plmwd/HKN-SAE-Project/README.md

# HKN-SAE-Project
A collaboration between UCF's HKN Zeta Chi and SAE club to expand SAE's measurement network for their formula racecar.
