plmwd/HKN-SAE-Project/Board/PowerSenseModule/bom/PowerSenseModule.xlsx

Sheet: BOM
Ref/Product | Qty | In Inventory | Unit Qty | To Order | Value | Footprint/Description | Manufacturer | Manufacturer PN
C4 C19 C21 C20 C22 C14 C11 C26 | 8 | Not in Inventory | 24 | 24 | 0.1uF | Capacitor_SMD:C_0603_1608Metric_Pad1.05x0.95mm_HandSolder | TDK | CGA3E2X7R1H104K080AA | Number of units to buy | 3
M3 Screws | 8 | 0 | 24 | 24 |  |  |  |  | Total number of parts TO BUY | 136
DT06-6S Pin | 6 | Not in Inventory | 18 | 18 | 1062-16-0122 | SOC, SF, SIZE 16, 14-18AWG, NI | TE Connectivity / DEUTSCH | 1062-16-0122 | Total number of parts | 255
C8 C12 C27 | 3 | 0 | 9 | 9 | 22uF | Capacitor_SMD:C_1210_3225Metric_Pad1.42x2.65mm_HandSolder | Samsung | CL32B226MOJNNNE
D1 D8 D9 | 3 | 0 | 9 | 9 | SMBJ9.0CA-13-F | Diode_SMD:D_SMB_Handsoldering | Diodes Incorporated | SMBJ9.0CA-13-F
C3 C13 C10 C24 | 4 | 4 | 12 | 8 | 0.01uF | Capacitor_SMD:C_0603_1608Metric_Pad1.05x0.95mm_HandSolder | KEMET | C0603C103J5RACTU
D2 D5 D6 D7 | 4 | 6 | 12 | 6 | DPUMP | Diode_SMD:D_SOD-323_HandSoldering | Toshiba | CUS10S30,H3F
R9 R6 | 2 | 0 | 6 | 6 | 0 | Resistor_SMD:R_2816_7142Metric_Pad3.20x4.45mm_HandSolder | Keystone Electronics | 5102
C15 | 1 | 0 | 3 | 3 | 10uF | Capacitor_Tantalum_SMD:CP_EIA-3528-12_Kemet-T_Pad1.50x2.35mm_HandSolder | KEMET | T491B106K016ATAUTO
J3 | 1 | 0 | 3 | 3 | Programming Header | Connector_PinHeader_2.54mm:PinHeader_1x06_P2.54mm_Vertical
J4 | 1 | 0 | 3 | 3 | Board Interconnect | Connector_PinHeader_2.54mm:PinHeader_1x02_P2.54mm_Vertical
U2 | 1 | 0 | 3 | 3 | NCV2007x | Package_SO:SOIC-14_3.9x8.7mm_P1.27mm | ON Semiconductor | NCV20074DTBR2G
DT13-6P Female Connector | 1 | Not in Inventory | 3 | 3 | DT06-6S | PLG, 6P, GRY, N | TE Connectivity / DEUTSCH | DT06-6S
DT06-6S Pin Wedge | 1 | Not in Inventory | 3 | 3 | W6S | WEDGE LOCK, 6P, PLG, ORG, STD, DT | TE Connectivity / DEUTSCH | W6S
Enclosure | 1 | Not in Inventory | 3 | 3 | HKN0000ENC01 | Power Sense Module enclosure | HKN | HKN000000ENC00
Enclosure O-Ring | 1 | 0 | 3 | 3
PCB | 1 | 0 | 3 | 3 |  |  | HKN | HKN000001PCB01
J1 | 1 | 1 | 3 | 2 | DT13-6P | Connector_TE:DT13-6P | TE Connectivity / DEUTSCH | DT13-6P | HKN part numbering
D3 | 1 | 2 | 3 | 1 | GREEN_LED | Resistor_SMD:R_0603_1608Metric_Pad1.05x0.95mm_HandSolder | Würth Elektronik | 150060VS75000 | suffix | hex num | type | type number 2 digit
D4 | 1 | 2 | 3 | 1 | RED_LED | Resistor_SMD:R_0603_1608Metric_Pad1.05x0.95mm_HandSolder | Würth Elektronik | 150060RS75000 | HKN | FFFFFF | ENC | FF
U3 | 1 | 2 | 3 | 1 | dsPIC33EV32GM102 | Package_SO:SSOP-28_5.3x10.2mm_P0.65mm | Microchip | dsPIC33EV32GM102-E/SS |  |  | SEN
C17 C18 | 2 | 8 | 6 | 0 | 10pF | Capacitor_SMD:C_0603_1608Metric_Pad1.05x0.95mm_HandSolder | Würth Elektronik | 885012206081 |  |  | PCB
C1 | 1 | 14 | 3 | 0 | 4.7pF | Capacitor_SMD:C_0603_1608Metric_Pad1.05x0.95mm_HandSolder | KEMET | C0603X479C1HACTU
C5 C23 C6 C25 | 4 | 13 | 12 | 0 | 4.7uF | Capacitor_SMD:C_0805_2012Metric_Pad1.15x1.40mm_HandSolder | Murata Electronics | GRM21BC81H475KE11L
C7 C2 | 2 | 8 | 6 | 0 | 470pF | Capacitor_SMD:C_0603_1608Metric_Pad1.05x0.95mm_HandSolder | KEMET | C0603C471J5GAC7411
C9 C16 | 2 | 8 | 6 | 0 | 33nF | Capacitor_SMD:C_0603_1608Metric_Pad1.05x0.95mm_HandSolder | TDK | CGA3E2X7R1H333M080AA
R11 R10 | 2 | 13 | 6 | 0 | 1.2k | Resistor_SMD:R_0603_1608Metric_Pad1.05x0.95mm_HandSolder | Panasonic | ERJ-PA3J122V
R13 R12 | 2 | 13 | 6 | 0 | 75k | Resistor_SMD:R_0603_1608Metric_Pad1.05x0.95mm_HandSolder | Panasonic | ERJ-PA3J753V
R14 R22 | 2 | 13 | 6 | 0 | 1k | Resistor_SMD:R_0603_1608Metric_Pad1.05x0.95mm_HandSolder | Panasonic | ERJ-PA3J102V
R17 R19 | 2 | 13 | 6 | 0 | 4.99k | Resistor_SMD:R_0603_1608Metric_Pad1.05x0.95mm_HandSolder | Vishay / Dale | RCS06034K99FKEA
R18 R4 R16 R15 | 4 | 16 | 12 | 0 | 10k | Resistor_SMD:R_0603_1608Metric_Pad1.05x0.95mm_HandSolder | Panasonic | ERJ-PA3J103V
R2 | 1 | 9 | 3 | 0 | 523k | Resistor_SMD:R_0603_1608Metric_Pad1.05x0.95mm_HandSolder | Bourns | CR0603-FX-5233ELF
R20 R21 | 2 | 13 | 6 | 0 | 300 | Resistor_SMD:R_0603_1608Metric_Pad1.05x0.95mm_HandSolder | Panasonic | ERJ-PA3J301V
R3 R1 | 2 | 8 | 6 | 0 | 100k | Resistor_SMD:R_0603_1608Metric_Pad1.05x0.95mm_HandSolder | Vishay / Dale | CRCW0603100KFKEA
R5 | 1 | 14 | 3 | 0 | 470 | Resistor_SMD:R_0603_1608Metric_Pad1.05x0.95mm_HandSolder | Panasonic | ERJ-PA3J471V
R7 | 1 | 14 | 3 | 0 | 120 | Resistor_SMD:R_0603_1608Metric_Pad1.05x0.95mm_HandSolder | Panasonic | ERJ-PA3J121V
R8 | 1 | 4 | 3 | 0 | 4m | Resistor_SMD:R_4020_10251Metric_Pad1.65x5.30mm_HandSolder | Vishay | WSLP39214L000FEB
U1 | 1 | 4 | 3 | 0 | TPS82150 | Package_LGA:Texas_SIL0008D_MicroSiP-8-1EP_2.8x3mm_P0.65mm_EP1.1x1.9mm | TI | TPS82150SILR
U4 | 1 | 5 | 3 | 0 | MCP2542FDxMF | Package_SO:SOIC-8_3.9x4.9mm_P1.27mm | Microchip | MCP2542FD-H/SN
Y1 | 1 | 3 | 3 | 0 | 25 MHz | ABRACON_4PIN:Crystal_SMD_S2.05mm_L2.55 | Abracon | ABM10AIG-25.000MHZ-4Z-T3

Sheet: Inventory
Qty | Value | In Design? | Footprint | Manufacturer | Manufacturer PN
3 | 0 | No | Resistor_SMD:R_0603_1608Metric_Pad1.05x0.95mm_HandSolder | Keystone | 5110
0 | 0 | Yes | Resistor_SMD:R_2816_7142Metric_Pad3.20x4.45mm_HandSolder | Keystone | 5102
4 | 0.01uF | Yes | Capacitor_SMD:C_0603_1608Metric_Pad1.05x0.95mm_HandSolder | KEMET | C0603C103J5RACTU
92 | 0.1uF | Yes | Capacitor_SMD:C_0603_1608Metric_Pad1.05x0.95mm_HandSolder | Murata Electronics | GRM21BR71C475KE51L
13 | 1.2k | Yes | Resistor_SMD:R_0603_1608Metric_Pad1.05x0.95mm_HandSolder | Panasonic | ERJ-PA3J122V
8 | 100k | Yes | Resistor_SMD:R_0603_1608Metric_Pad1.05x0.95mm_HandSolder | Vishay / Dale | CRCW0603100KFKEA
16 | 10k | Yes | Resistor_SMD:R_0603_1608Metric_Pad1.05x0.95mm_HandSolder | Panasonic | ERJ-PA3J103V
0 | 10pF | No | Capacitor_SMD:C_0603_1608Metric_Pad1.05x0.95mm_HandSolder | KEMET | C0603C100J5GAC3190
8 | 10pF | Yes | Capacitor_SMD:C_0603_1608Metric_Pad1.05x0.95mm_HandSolder | Würth Elektronik | 885012206081
0 | 10uF | No | Capacitor_Tantalum_SMD:CP_EIA-3528-12_Kemet-T_Pad1.50x2.35mm_HandSolder | KEMET | T491B106K016ATAUTO
0 | 10uF | No | Capacitor_Tantalum_SMD:CP_EIA-3528-12_Kemet-T_Pad1.50x2.35mm_HandSolder | Würth Elektronik | 885012206092
2 | 10uF | Yes | Capacitor_Tantalum_SMD:CP_EIA-3528-12_Kemet-T_Pad1.50x2.35mm_HandSolder | AVX | TPSB106K020R0500
14 | 120 | Yes | Resistor_SMD:R_0603_1608Metric_Pad1.05x0.95mm_HandSolder | Panasonic | ERJ-PA3J121V
13 | 1k | Yes | Resistor_SMD:R_0603_1608Metric_Pad1.05x0.95mm_HandSolder | Panasonic | ERJ-PA3J102V
0 | 22uF | Yes | Capacitor_SMD:C_1210_3225Metric_Pad1.42x2.65mm_HandSolder | Samsung | CL32B226MOJNNNE
3 | 25 MHz | Yes | ABRACON_4PIN:Crystal_SMD_S2.05mm_L2.55 | Abracon | ABM10AIG-25.000MHZ-4Z-T3
13 | 300 | Yes | Resistor_SMD:R_0603_1608Metric_Pad1.05x0.95mm_HandSolder | Panasonic | ERJ-PA3J301V
8 | 33nF | Yes | Capacitor_SMD:C_0603_1608Metric_Pad1.05x0.95mm_HandSolder | TDK | CGA3E2X7R1H333M080AA
14 | 4.7pF | Yes | Capacitor_SMD:C_0603_1608Metric_Pad1.05x0.95mm_HandSolder | KEMET | C0603X479C1HACTU
13 | 4.7uF | Yes | Capacitor_SMD:C_0805_2012Metric_Pad1.15x1.40mm_HandSolder | Murata Electronics | GRM21BC81H475KE11L
13 | 4.99k | Yes | Resistor_SMD:R_0603_1608Metric_Pad1.05x0.95mm_HandSolder | Vishay / Dale | RCS06034K99FKEA
14 | 470 | Yes | Resistor_SMD:R_0603_1608Metric_Pad1.05x0.95mm_HandSolder | Panasonic | ERJ-PA3J471V
8 | 470pF | Yes | Capacitor_SMD:C_0603_1608Metric_Pad1.05x0.95mm_HandSolder | KEMET | C0603C471J5GAC7411
2 | 47uF | No | Capacitor_SMD:C_1210_3225Metric_Pad1.42x2.65mm_HandSolder | Taiyo Yuden | EMK325ABJ476MMHP
3 | 4m | Yes | Resistor_SMD:R_4020_10251Metric_Pad1.65x5.30mm_HandSolder | Vishay | WSLP39214L000FEA
4 | 4m | Yes | Resistor_SMD:R_4020_10251Metric_Pad1.65x5.30mm_HandSolder | Vishay | WSLP39214L000FEB
9 | 523k | Yes | Resistor_SMD:R_0603_1608Metric_Pad1.05x0.95mm_HandSolder | Bourns | CR0603-FX-5233ELF
2 | 6.8uF | No | Capacitor_SMD:C_1210_3225Metric_Pad1.42x2.65mm_HandSolder | TDK | CGA6P3X7S1H685K250AB
13 | 75k | Yes | Resistor_SMD:R_0603_1608Metric_Pad1.05x0.95mm_HandSolder | Panasonic | ERJ-PA3J753V
6 | DPUMP | Yes | Diode_SMD:D_SOD-323_HandSoldering | Toshiba | CUS10S30,H3F
2 | dsPIC33EV32GM102 | Yes | Package_SO:SSOP-28_5.3x10.2mm_P0.65mm | Microchip | dsPIC33EV32GM102-E/SS
1 | DT13-6P | Yes | Connector_TE:DT13-6P | TE Connectivity / DEUTSCH | DT13-6P
2 | GREEN_LED | Yes | Resistor_SMD:R_0603_1608Metric_Pad1.05x0.95mm_HandSolder | Wurth Elektronik | 150060VS75000
 | Male Headers | Yes | Connector_PinHeader_2.54mm:PinHeader_1x01_P2.54mm_Vertical
5 | MCP2542FDxMF | Yes | Package_SO:SOIC-8_3.9x4.9mm_P1.27mm | Microchip | MCP2542FD-H/SN
0 | NCV2007x | Yes | Package_SO:TSSOP-14_4.4x5mm_P0.65mm | ON Semiconductor | NCV20074DTBR2G
6 | NCV2007x | No | Package_SO:SOIC-14_3.9x8.7mm_P1.27mm | ON Semiconductor | NCV20074DR2G
2 | RED_LED | Yes | Resistor_SMD:R_0603_1608Metric_Pad1.05x0.95mm_HandSolder | Wurth Elektronik | 150060RS75000
0 | SMBJ9.0CA-13-F | Yes | Diode_SMD:D_SMB_Handsoldering | Diodes Incorporated | SMBJ9.0CA-13-F
4 | TPS82150 | Yes | Package_LGA:Texas_SIL0008D_MicroSiP-8-1EP_2.8x3mm_P0.65mm_EP1.1x1.9mm | TI | TPS82150SILR
9 | PCB Rev 1 | No |  | HKN | HKN000001PCB00
0 | PCB Rev 1.1 | Yes |  | HKN | HKN000001PCB01
