plmwd/HKN-SAE-Project/Board/PowerSenseModule/bom/PowerSenseModule.csv

Ref | Qty | Value | Footprint | Manufacturer | Manufacturer PN | Price 1 QTY | Supplier | Supplier Link | Supplier PN
C7 C2 | 2 | 470pF | Capacitor_SMD:C_0603_1608Metric_Pad1.05x0.95mm_HandSolder | KEMET | C0603C471J5GAC7411 | 0.21 | Mouser | https://www.mouser.com/ProductDetail/KEMET/C0603C471J5GAC7411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 | 80-C0603C471J5G7411
C5 C23 C6 C25 | 4 | 4.7uF | Capacitor_SMD:C_0805_2012Metric_Pad1.15x1.40mm_HandSolder | Murata Electronics | GRM21BC81H475KE11L | 0.49 | Digikey | https://www.digikey.com/product-detail/en/murata-electronics/GRM21BC81H475KE11L/490-14658-1-ND/6606264 | 490-14658-1-ND
C4 C19 C21 C20 C22 C14 C11 C26 | 8 | 0.1uF | Capacitor_SMD:C_0603_1608Metric_Pad1.05x0.95mm_HandSolder | TDK | CGA3E2X7R1H104K080AA | 0.1 | Mouser | https://www.mouser.com/ProductDetail/TDK/CGA3E2X7R1H104K080AA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 | 810-CGA3E2X7R1H104K
C3 C13 C10 C24 | 4 | 0.01uF | Capacitor_SMD:C_0603_1608Metric_Pad1.05x0.95mm_HandSolder | KEMET | C0603C103J5RACTU | 0.10 | Mouser | https://www.mouser.com/ProductDetail/KEMET/C0603C103J5RACTU?qs=sGAEpiMZZMs0AnBnWHyRQJxdEn2F2BG1SUc13Z4vudE%3D | 80-C0603C103J5R
C1 | 1 | 4.7pF | Capacitor_SMD:C_0603_1608Metric_Pad1.05x0.95mm_HandSolder | KEMET | C0603X479C1HACTU | 0.12 | Mouser | https://www.mouser.com/ProductDetail/KEMET/C0603X479C1HACTU | 80-C0603X479C1HACTU
C8 C12 C27 | 3 | 22uF | Capacitor_SMD:C_1210_3225Metric_Pad1.42x2.65mm_HandSolder | Samsung | CL32B226MOJNNNE | 0.61 | Digikey | https://www.digikey.com/product-detail/en/samsung-electro-mechanics/CL32B226MOJNNNE/1276-3395-1-ND/3891481 | 1276-3395-1-ND
C17 C18 | 2 | 10pF | Capacitor_SMD:C_0603_1608Metric_Pad1.05x0.95mm_HandSolder | KEMET | C0603C100J5GAC3190 | 0.1 | Mouser | https://www.mouser.com/ProductDetail/KEMET/C0603C100J5GAC3190 | 80-C0603C100J5G3190
C9 C16 | 2 | 33nF | Capacitor_SMD:C_0603_1608Metric_Pad1.05x0.95mm_HandSolder | TDK | CGA3E2X7R1H333M080AA | 0.1 | Mouser | https://www.mouser.com/ProductDetail/TDK/CGA3E2X7R1H333M080AA | 810-CGA3E2X7R1H333MA
C15 | 1 | 10uF | Capacitor_Tantalum_SMD:CP_EIA-3528-12_Kemet-T_Pad1.50x2.35mm_HandSolder | KEMET | T491B106K016ATAUTO | 0.57 | Mouser | https://www.mouser.com/ProductDetail/KEMET/T491B106K016ATAUTO | 80-T491B106K016AUTO
D2 D5 D6 D7 | 4 | DPUMP | Diode_SMD:D_SOD-323_HandSoldering | Toshiba | CUS10S30 H3F | 0.42 | Mouser | https://www.mouser.com/ProductDetail/Toshiba/CUS10S30H3F | 757-CUS10S30H3F
D1 D8 D9 | 3 | SMBJ9.0CA-13-F | Diode_SMD:D_SMB_Handsoldering | Diodes Incorporated | SMBJ9.0CA-13-F | 0.36 | Digikey | https://www.digikey.com/product-detail/en/diodes-incorporated/SMBJ9.0CA-13-F/SMBJ9.0CA-FDICT-ND/775877 | SMBJ9.0CA-FDICT-ND
D4 | 1 | RED_LED | Resistor_SMD:R_0603_1608Metric_Pad1.05x0.95mm_HandSolder | Würth Elektronik | 150060RS75000 | 0.14 | Digikey | https://www.digikey.com/product-detail/en/w-rth-elektronik/150060RS75000/732-4978-1-ND/4489899 | 732-4978-1-ND
D3 | 1 | GREEN_LED | Resistor_SMD:R_0603_1608Metric_Pad1.05x0.95mm_HandSolder | Würth Elektronik | 150060VS75000 | 0.14 | Digikey | https://www.digikey.com/product-detail/en/w-rth-elektronik/150060VS75000/732-4980-1-ND/4489904 | 732-4980-1-ND
G1 | 1 | LOGO | Logo:HKNZetaChi
H1 H2 | 2 |  | MountingHole:MountingHole_2.7mm_M2.5_Pad
J1 | 1 | DT13-6P | Connector_TE:DT13-6P | TE Connectivity / DEUTSCH | DT13-6P | 9.15 | Mouser | https://www.mouser.com/ProductDetail/TE-Connectivity-DEUTSCH/DT13-6P | 571-DT13-6P
J3 | 1 | Programming Header | Connector_PinHeader_2.54mm:PinHeader_1x06_P2.54mm_Vertical |  |  |  |  | https://www.amazon.com/gp/product/B07VNXL5BD/ref=ppx_yo_dt_b_asin_title_o04_s00?ie=UTF8&psc=1
J4 | 1 | Board Interconnect | Connector_PinHeader_2.54mm:PinHeader_1x02_P2.54mm_Vertical |  |  |  |  | https://www.amazon.com/gp/product/B07VNXL5BD/ref=ppx_yo_dt_b_asin_title_o04_s00?ie=UTF8&psc=1
NT1 | 1 | Net-Tie_2 | NetTie:NetTie-2_SMD_Pad2.0mm
R3 R1 | 2 | 100k | Resistor_SMD:R_0603_1608Metric_Pad1.05x0.95mm_HandSolder | Vishay / Dale | CRCW0603100KFKEA | 0.1 | Mouser | https://www.mouser.com/ProductDetail/Vishay-Dale/CRCW0603100KFKEA | 71-CRCW0603-100K-E3
R2 | 1 | 523k | Resistor_SMD:R_0603_1608Metric_Pad1.05x0.95mm_HandSolder | Bourns | CR0603-FX-5233ELF | 0.1 | Mouser | https://www.mouser.com/ProductDetail/Bourns/CR0603-FX-5233ELF | 652-CR0603FX-5233ELF
R7 | 1 | 120 | Resistor_SMD:R_0603_1608Metric_Pad1.05x0.95mm_HandSolder | Panasonic | ERJ-PA3J121V | 0.1 | Digikey | https://www.digikey.com/product-detail/en/panasonic-electronic-components/ERJ-PA3J121V/P120BZCT-ND/5036246 | P120BZCT-ND
R20 R21 | 2 | 300 | Resistor_SMD:R_0603_1608Metric_Pad1.05x0.95mm_HandSolder | Panasonic | ERJ-PA3J301V | 0.1 | Digikey | https://www.digikey.com/product-detail/en/panasonic-electronic-components/ERJ-PA3J301V/P300BZCT-ND/5036302 | P300BZCT-ND
R9 R6 | 2 | 0 | Resistor_SMD:R_2816_7142Metric_Pad3.20x4.45mm_HandSolder | Keystone | 5102 | 0.22 | Digikey | https://www.digikey.com/product-detail/en/keystone-electronics/5102/36-5102-ND/4780768 | 36-5102-ND
R14 R22 | 2 | 1k | Resistor_SMD:R_0603_1608Metric_Pad1.05x0.95mm_HandSolder | Panasonic | ERJ-PA3J102V | 0.1 | Digikey | https://www.digikey.com/product-detail/en/panasonic-electronic-components/ERJ-PA3J102V/P1KBZCT-ND/5036236 | P1KBZCT-ND
R13 R12 | 2 | 75k | Resistor_SMD:R_0603_1608Metric_Pad1.05x0.95mm_HandSolder | Panasonic | ERJ-PA3J753V | 0.1 | Digikey | https://www.digikey.com/product-detail/en/panasonic-electronic-components/ERJ-PA3J753V/P75KBZCT-ND/5036364 | P75KBZCT-ND
R8 | 1 | 4m | Resistor_SMD:R_4020_10251Metric_Pad1.65x5.30mm_HandSolder | Vishay | WSLP39214L000FEB | 2.18 | Mouser | https://www.mouser.com/ProductDetail/Vishay-Dale/WSLP39214L000FEB | 71- 71-WSLP39214L000FEB
R17 R19 | 2 | 4.99k | Resistor_SMD:R_0603_1608Metric_Pad1.05x0.95mm_HandSolder | Vishay / Dale | RCS06034K99FKEA | 0.14 | Digikey | https://www.digikey.com/product-detail/en/vishay-dale/RCS06034K99FKEA/541-2794-1-ND/5867087 | 541-2794-1-ND
R18 R4 R16 R15 | 4 | 10k | Resistor_SMD:R_0603_1608Metric_Pad1.05x0.95mm_HandSolder | Panasonic | ERJ-PA3J103V | 0.1 | Digikey | https://www.digikey.com/product-detail/en/panasonic-electronic-components/ERJ-PA3J103V/P10KBZCT-ND/5036237 | P10KBZCT-ND
R5 | 1 | 470 | Resistor_SMD:R_0603_1608Metric_Pad1.05x0.95mm_HandSolder | Panasonic | ERJ-PA3J471V | 0.1 | Digikey | https://www.digikey.com/product-detail/en/panasonic-electronic-components/ERJ-PA3J471V/P470BZCT-ND/5036331 | P470BZCT-ND
R11 R10 | 2 | 1.2k | Resistor_SMD:R_0603_1608Metric_Pad1.05x0.95mm_HandSolder | Panasonic | ERJ-PA3J122V | 0.1 | Digikey | https://www.digikey.com/product-detail/en/panasonic-electronic-components/ERJ-PA3J122V/P1.2KBZCT-ND/5036247 | P1.2KBZCT-ND
U1 | 1 | TPS82150 | Package_LGA:Texas_SIL0008D_MicroSiP-8-1EP_2.8x3mm_P0.65mm_EP1.1x1.9mm | TI | TPS82150SILR | 3.03 | Mouser | https://www.mouser.com/ProductDetail/?qs=gt1LBUVyoHksxpRVOmIIkg%3D%3D | 595-TPS82150SILR
U4 | 1 | MCP2542FDxMF | Package_SO:SOIC-8_3.9x4.9mm_P1.27mm | Microchip | MCP2542FD-H/SN | 0.79 | Mouser | https://www.mouser.com/ProductDetail/Microchip-Technology/MCP2542FD-H-SN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 | 579-MCP2542FD-H/SN
U2 | 1 | NCV2007x | Package_SO:SOIC-14_3.9x8.7mm_P1.27mm | ON Semiconductor | NCV20074DTBR2G | 1.01 | Digikey | https://www.digikey.com/product-detail/en/on-semiconductor/NCV20074DTBR2G/NCV20074DTBR2GOSCT-ND/9087194 | NCV20074DTBR2GOSCT-ND
U3 | 1 | dsPIC33EV32GM102 | Package_SO:SSOP-28_5.3x10.2mm_P0.65mm | Microchip | dsPIC33EV32GM102-E/SS | 3.04 | Mouser | https://www.mouser.com/ProductDetail/Microchip-Technology/dsPIC33EV32GM102-E-SS | 579-33EV32GM102ESS
Y1 | 1 | 25 MHz | ABRACON_4PIN:Crystal_SMD_S2.05mm_L2.55 | Abracon | ABM10AIG-25.000MHZ-4Z-T3 | 1.30 | Mouser | https://www.mouser.com/ProductDetail/ABRACON/ABM10AIG-25000MHZ-4Z-T3 | 815-M10AIG-25-4ZT3
