plmwd/HKN-SAE-Project/Design Files/PowerSenseModule.xlsx

Ref | Qnty | Value | Supplier | Supplier Part Number | Manufacture Part Number | Unit Price | Price Break | Qnty Price | Extended Price | Extended Order Price | Link | Footprint | Description
C1, | 1 | 4.7pF | Digikey | 1276-1282-1-ND | CL10C4R7CB8NNNC | 0.0257 | 100 | 0.0257 | 2.57 | 2.57 | https://www.digikey.com/product-detail/en/samsung-electro-mechanics/CL10C4R7CB8NNNC/1276-1282-1-ND/3889368 | Capacitor_SMD:C_0603_1608Metric_Pad1.05x0.95mm_HandSolder | Unpolarized capacitor
C2, C7 | 2 | 470pF | Digikey | 1276-6635-1-ND | CL10B471KB8WPNC | 0.0186 | 100 | 0.0372 | 1.86 | 1.86 | https://www.digikey.com/product-detail/en/samsung-electro-mechanics/CL10B471KB8WPNC/1276-6635-1-ND/5961494 | Capacitor_SMD:C_0603_1608Metric_Pad1.05x0.95mm_HandSolder | Unpolarized capacitor
C3, C10, C13, C21, | 4 | 0.01uF | Digikey | 1276-6841-1-ND | CL10B103KB8WPNC | 0.0282 | 100 | 0.1128 | 2.82 | 2.82 | https://www.digikey.com/product-detail/en/samsung-electro-mechanics/CL10B103KB8WPNC/1276-6841-1-ND/5961700 | Capacitor_SMD:C_0603_1608Metric_Pad1.05x0.95mm_HandSolder | Unpolarized capacitor
C4, C12, C11, C14, C24, C20, C23, | 7 | 0.1uF | Digikey | 1276-6994-1-ND | CL10B104KB85PNL | 0.0437 | 100 | 0.3059 | 4.37 | 4.37 | https://www.digikey.com/product-detail/en/samsung-electro-mechanics/CL10B104KB85PNL/1276-6994-1-ND/7320636 | Capacitor_SMD:C_0603_1608Metric_Pad1.05x0.95mm_HandSolder | Unpolarized capacitor
C5, | 1 | 4.7uF | Digikey | 1276-2969-1-ND | CL21B475KAFNNNE | 0.305 | 10 | 0.305 | 3.05 | 3.05 | https://www.digikey.com/product-detail/en/samsung-electro-mechanics/CL21B475KAFNNNE/1276-2969-1-ND/3891055 | Capacitor_SMD:C_0805_2012Metric_Pad1.15x1.40mm_HandSolder | Unpolarized capacitor
C6, | 1 | 10uF | Digikey | PCE4549CT-ND | EEE-FPV100UAR | 0.29 | 10 | 0.29 | 2.9 | 2.9 | https://www.digikey.com/product-detail/en/panasonic-electronic-components/EEE-FPV100UAR/PCE4549CT-ND/1701048 | elec 4x5.8 | Unpolarized capacitor
C8, | 1 | 47uF | Digikey | PCE4552CT-ND | EEE-FP1V470AP | 0.36 | 10 | 0.36 | 3.6 | 3.6 | https://www.digikey.com/product-detail/en/panasonic-electronic-components/EEE-FP1V470AP/PCE4552CT-ND/1701051 | elec 6.3x5.8 | Unpolarized capacitor
C9, | 1 | 150uF | Digikey | PCE5016CT-ND | EEE-FT1V101AP | 0.417 | 10 | 0.417 | 4.17 | 4.17 | https://www.digikey.com/product-detail/en/panasonic-electronic-components/EEE-FT1V101AP/PCE5016CT-ND/2652071 | elec 6.3x5.9 | Polarized capacitor
C15, | 1 | 10uF | Digikey | 718-2156-1-ND | T55B106M016C0100 | 1.09 | 1 | 1.09 | 1.09 | 10.9 | https://www.digikey.com/product-detail/en/vishay-sprague/T55B106M016C0100/718-2156-1-ND/6230386 | tantalum 3528 | Polarized capacitor, US symbol
C16, C17, | 2 | 3.3nF | Digikey | 399-17588-1-ND | C0603C302K5JACAUTO | 0.0365 | 100 | 0.073 | 3.65 | 3.65 | https://www.digikey.com/product-detail/en/kemet/C0603C332J5RACAUTO/399-17588-1-ND/8572588 | Capacitor_SMD:C_0603_1608Metric_Pad1.05x0.95mm_HandSolder | Unpolarized capacitor
C18, | 1 | 820pF | Digikey | 399-17600-1-ND | C0603C821K5RACAUTO | 0.0506 | 100 | 0.0506 | 5.06 | 5.06 | https://www.digikey.com/product-detail/en/kemet/C0603C821K5RACAUTO/399-17600-1-ND/8572600 | Capacitor_SMD:C_0603_1608Metric_Pad1.05x0.95mm_HandSolder | Unpolarized capacitor
C19, C22, | 2 | 1uF | Digikey | 1276-6470-1-ND | CL21B105KBFNNNG | 0.0477 | 100 | 0.0954 | 4.77 | 4.77 | https://www.digikey.com/product-detail/en/samsung-electro-mechanics/CL21B105KBFNNNG/1276-6470-1-ND/5958098 | Capacitor_SMD:C_0805_2012Metric_Pad1.15x1.40mm_HandSolder | Unpolarized capacitor
D2, D1, | 2 | TVS1400 | Digikey | 296-50511-1-ND | TVS1400DRVR | 0.545 | 10 | 1.09 | 5.45 | 5.45 | https://www.digikey.com/product-detail/en/texas-instruments/TVS1400DRVR/296-50511-1-ND/9685650 | Package_SON_Custom:WSON-6-2NET-1EP_2x2mm_P0.65mm_EP1x1.6mm | 14-V Flat-Clamp Surge Protection Device
J2, | 1 | Power/CAN Connector | Digikey | 1734-1025-ND | DT13-6P | 9.18 | 1 | 9.18 | 9.18 | 91.8 | https://www.digikey.com/products/en?keywords=dt13-6p | Connector_TE:DT13-6P
J3, | 1 | Programming Header | Digikey |  |  |  |  | 0 | 0 | 0 |  | Connector_PinHeader_2.54mm:PinHeader_1x06_P2.54mm_Vertical
JP1, | 1 | Jumper_NO_Small | Digikey |  |  |  |  | 0 | 0 | 0 |  | Connector_PinHeader_2.54mm:PinHeader_1x02_P2.54mm_Vertical | Jumper, normally open, small symbol
R2, | 1 | 523k | Digikey |  |  |  |  | 0 | 0 | 0 |  | Resistor_SMD:R_0603_1608Metric_Pad1.05x0.95mm_HandSolder | Resistor, US symbol
R3, R1, | 2 | 100k | Digikey |  |  |  |  | 0 | 0 | 0 |  | Resistor_SMD:R_0603_1608Metric_Pad1.05x0.95mm_HandSolder | Resistor, US symbol
R4, R6, R17, R15, | 4 | 10k | Digikey |  |  |  |  | 0 | 0 | 0 |  | Resistor_SMD:R_0603_1608Metric_Pad1.05x0.95mm_HandSolder | Resistor, US symbol
R5, | 1 | 470 | Digikey |  |  |  |  | 0 | 0 | 0 |  | Resistor_SMD:R_0603_1608Metric_Pad1.05x0.95mm_HandSolder | Resistor, US symbol
R7, | 1 | 120 | Digikey |  |  |  |  | 0 | 0 | 0 |  | Resistor_SMD:R_0603_1608Metric_Pad1.05x0.95mm_HandSolder | Resistor, US symbol
R8, | 1 | 2m | Digikey |  |  |  |  | 0 | 0 | 0 |  | Resistor_SMD:R_Shunt_Vishay_WSK2512_6332Metric_T1.19mm | Shunt resistor, US symbol
R9, R12, | 2 | 499k | Digikey |  |  |  |  | 0 | 0 | 0 |  | Resistor_SMD:R_0603_1608Metric_Pad1.05x0.95mm_HandSolder | Resistor, US symbol
R11, R10, R14, | 3 | 1k | Digikey |  |  |  |  | 0 | 0 | 0 |  | Resistor_SMD:R_0603_1608Metric_Pad1.05x0.95mm_HandSolder | Resistor, US symbol
R13, | 1 | 34.8k | Digikey |  |  |  |  | 0 | 0 | 0 |  | Resistor_SMD:R_0603_1608Metric_Pad1.05x0.95mm_HandSolder | Resistor, US symbol
R16, | 1 | 10 | Digikey |  |  |  |  | 0 | 0 | 0 |  | Resistor_SMD:R_0603_1608Metric_Pad1.05x0.95mm_HandSolder | Resistor, US symbol
U1, | 1 | TPS82150 | Digikey | 296-50509-1-ND | TPS82150SILR | 3.12 | 1 | 3.12 | 3.12 | 31.2 | https://www.digikey.com/product-detail/en/texas-instruments/TPS82150SILR/296-50509-1-ND/9685648 | Package_LGA:Texas_SIL0008D_MicroSiP-8-1EP_2.8x3mm_P0.65mm_EP1.1x1.9mm | 17V Input 1A Step-Down Converter MicroSiP Module with Integrated Inductor, Î¼SiL-8
U2, | 1 | ZLDO117 | Digikey | ZLDO1117QG33TADICT-ND | ZLDO1117QG33TA | 0.544 | 10 | 0.544 | 5.44 | 5.44 | https://www.digikey.com/product-detail/en/diodes-incorporated/ZLDO1117QG33TA/ZLDO1117QG33TADICT-ND/8545998 | Package_TO_SOT_SMD:SOT-223 | LDO linear regular - fixed 3V3
U3, | 1 | dsPIC33EP32GP502 | Digikey | DSPIC33EP32GP502-E/MM-ND | DSPIC33EP32GP502-E/MM | 2.55 | 1 | 2.55 | 2.55 | 25.5 | https://www.digikey.com/product-detail/en/microchip-technology/DSPIC33EP32GP502-E-MM/DSPIC33EP32GP502-E-MM-ND/3871860 | Package_DFN_QFN:QFN-28-1EP_6x6mm_P0.65mm_EP4.25x4.25mm_ThermalVias | 16bit MCU
U4, | 1 | MCP2542FDxMF | Digikey | MCP2542FD-E/MF-ND | MCP2542FD-E/MF | 0.83 | 1 | 0.83 | 0.83 | 8.3 | https://www.digikey.com/product-detail/en/microchip-technology/MCP2542FD-E-MF/MCP2542FD-E-MF-ND/9826383 | Package_DFN_QFN:DFN-8-1EP_3x3mm_P0.65mm_EP1.55x2.4mm | CAN-FD Transceiver, Wake-Up on CAN activity, 8Mbps, 5V supply, STBY pin, 3x3 DFN-8
U5, | 1 | MCP9700AT-ETT | Digikey | MCP9700AT-E/TTCT-ND | MCP9700AT-E/TT | 0.32 | 1 | 0.32 | 0.32 | 3.2 | https://www.digikey.com/product-detail/en/microchip-technology/MCP9700AT-E-TT/MCP9700AT-E-TTCT-ND/3622388 | Package_TO_SOT_SMD:SOT-23 | Low power, analog thermistor temperature sensor, Â±2C accuracy, -40C to +125C, in SOT-23-3
U6, | 1 | MCP39F511A | Digikey | MCP39F511AT-E/MQCT-ND | MCP39F511AT-E/MQ | 2.6 | 1 | 2.6 | 2.6 | 26 | https://www.digikey.com/product-detail/en/microchip-technology/MCP39F511AT-E-MQ/MCP39F511AT-E-MQCT-ND/8639369 | Package_DFN_QFN:QFN-28-1EP_5x5mm_P0.5mm_EP3.35x3.35mm | Power sensing module
Total
# of Components per Unit | 52
Unit Price | 23.3966
# Units | 10
Buy Price | 246.61
