plmwd/HKN-SAE-Project/Board/PowerSenseModule/bom/PowerSenseModule-Order-OSHPark.png

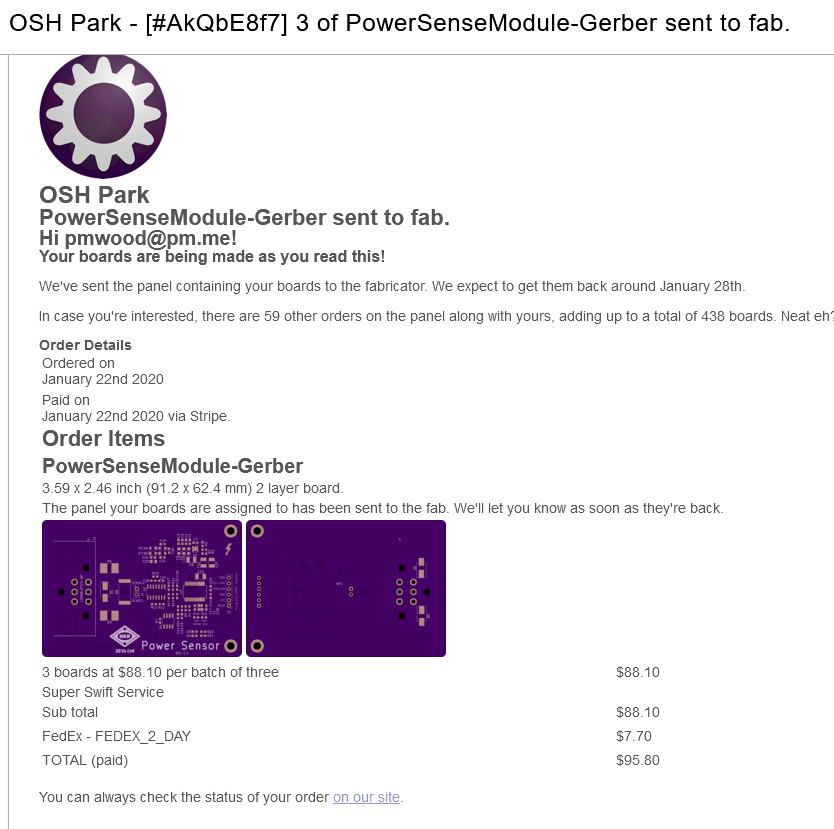
Board/PowerSenseModule/bom/PowerSenseModule-Order-OSHPark.png
