plmwd/HKN-SAE-Project/Board/WBDesign_BuckConverter.pdf

## WEBENCH ® Design Report

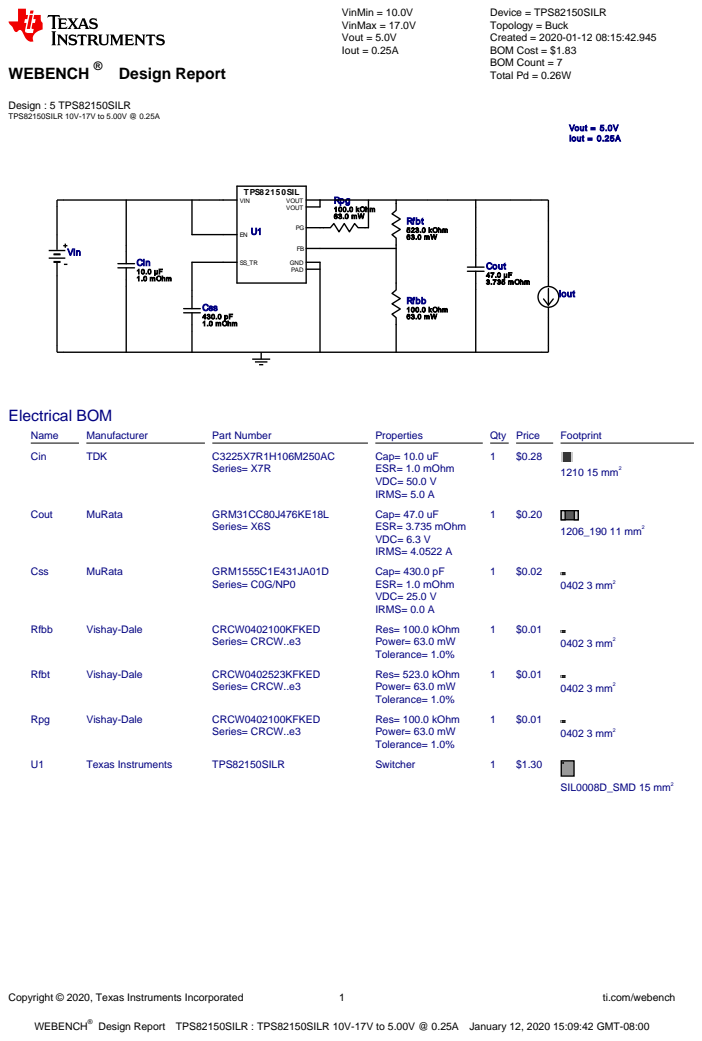
[picture p2: page 1]
Copyright © 2020, Texas Instruments Incorporated; ti.com/webench; WEBENCH®; Design : 5 TPS82150SILR TPS82150SILR 10V-17V to 5.00V @ 0.25A; VinMin = 10.0V VinMax = 17.0V Vout = 5.0V Iout = 0.25A; Device = TPS82150SILR Topology = Buck Created = 2020-01-12 08:15:42.945 BOM Cost = $1.83 BOM Count = 7 Total Pd = 0.26W; Cin 10.0 µF 1.0 mOhm; Cout 47.0 µF 3.735 mOhm; Css 430.0 pF 1.0 mOhm; Rfbb 100.0 kOhm 63.0 mW; Rfbt 523.0 kOhm 63.0 mW; Rpg 100.0 kOhm 63.0 mW; TPS82150SIL; VIN; GND; VOUT VOUT; PAD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

Design Report TPS82150SILR : TPS82150SILR 10V-17V to 5.00V @ 0.25A January 12, 2020 15:09:42 GMT-08:00

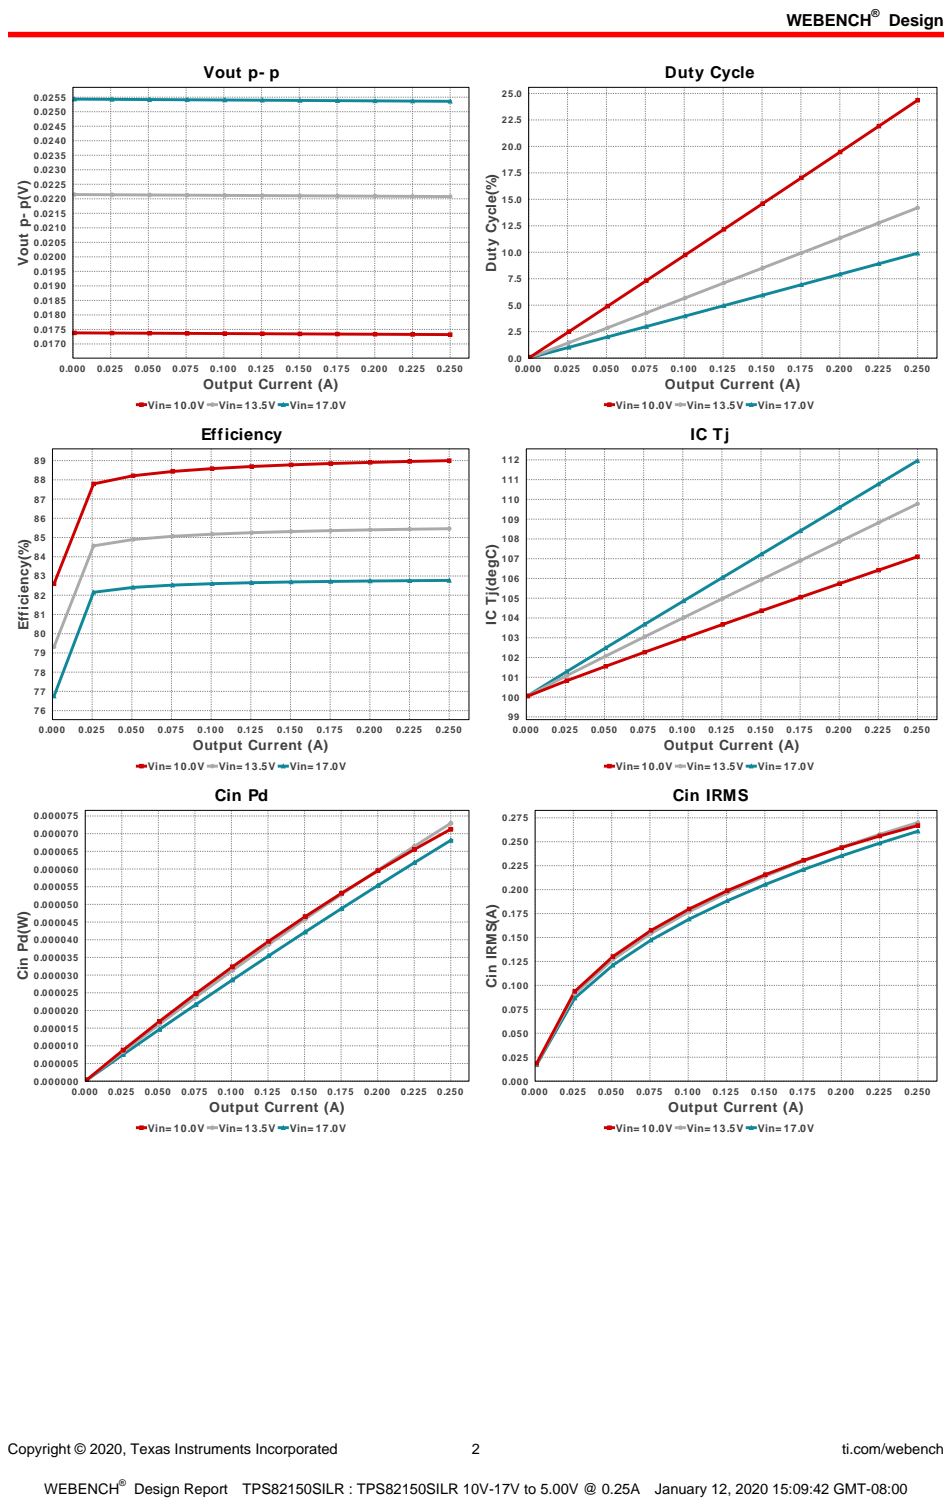
[picture p3: page 2]
Design; Copyright © 2020, Texas Instruments Incorporated; ti.com/webench; Vout p- p; 0.000 0.025 0.050 0.075 0.100 0.125 0.150 0.175 0.200 0.225 0.250 Output Current (A); Vout p- p(V); Duty Cycle; Duty Cycle(%); 0.250 Output Current (A); Efficiency(%); Cin Pd; Cin Pd(W); Cin IRMS(A)

Vin= 10.0V Vin= 13.5V Vin= 17.0V
Efficiency

IC Tj(degC)

Cin IRMS

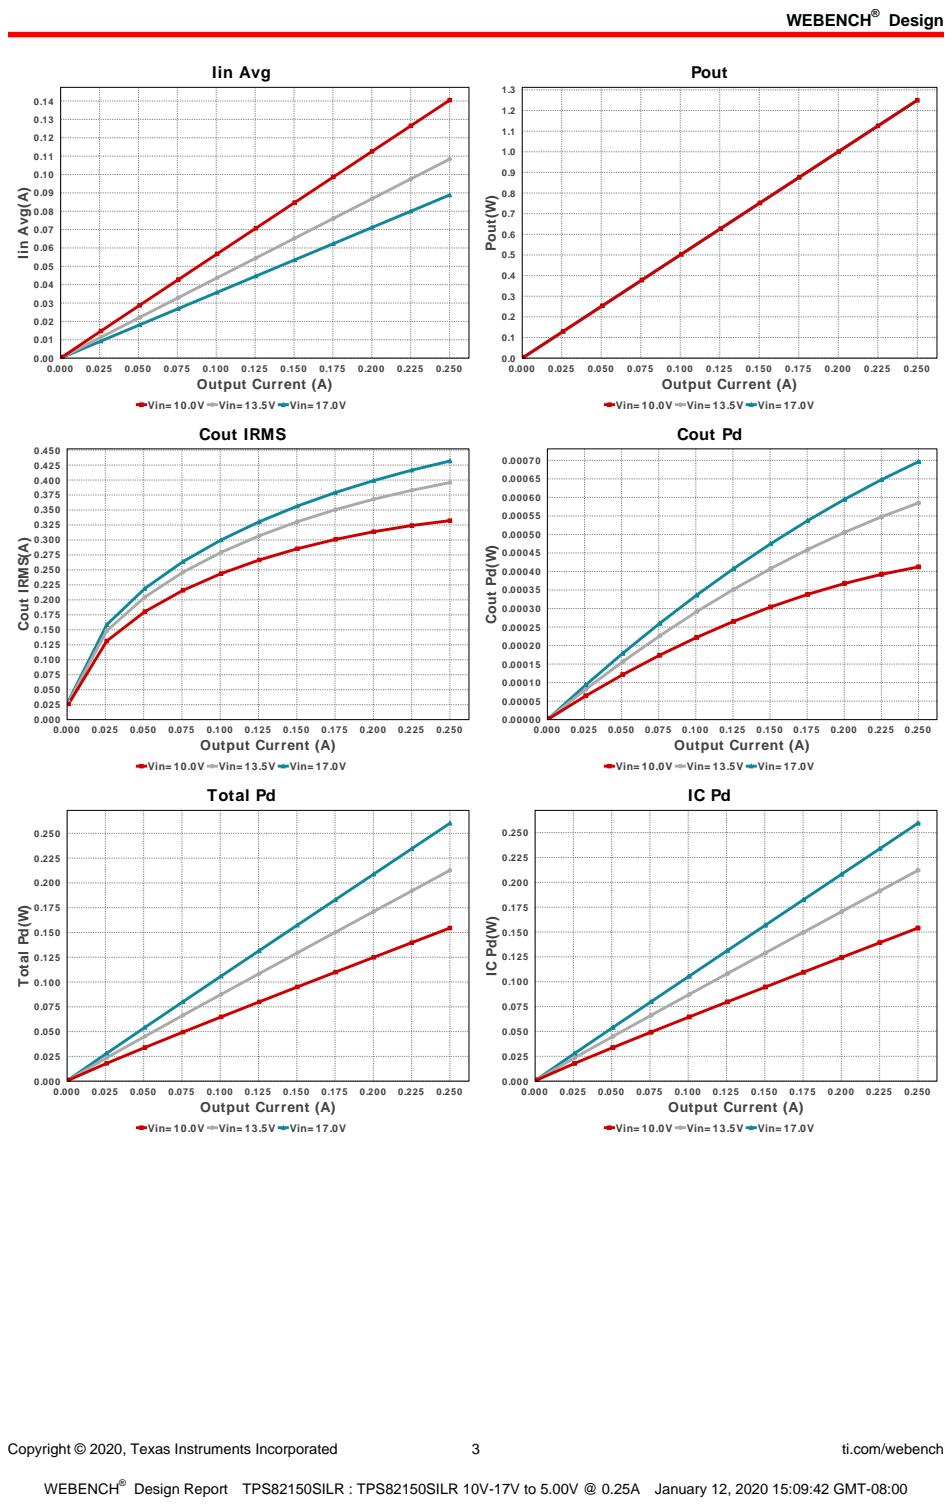
[picture p4: page 3]
Copyright © 2020, Texas Instruments Incorporated; ti.com/webench; Iin Avg; 0.000 0.025 0.050 0.075 0.100 0.125 0.150 0.175 0.200 0.225 0.250 Output Current (A); Iin Avg(A); Pout; 0.250 Output Current (A); Pout(W); Cout IRMS(A); Cout Pd; Cout Pd(W); Total Pd; Total Pd(W)

Vin= 10.0V Vin= 13.5V Vin= 17.0V
Cout IRMS

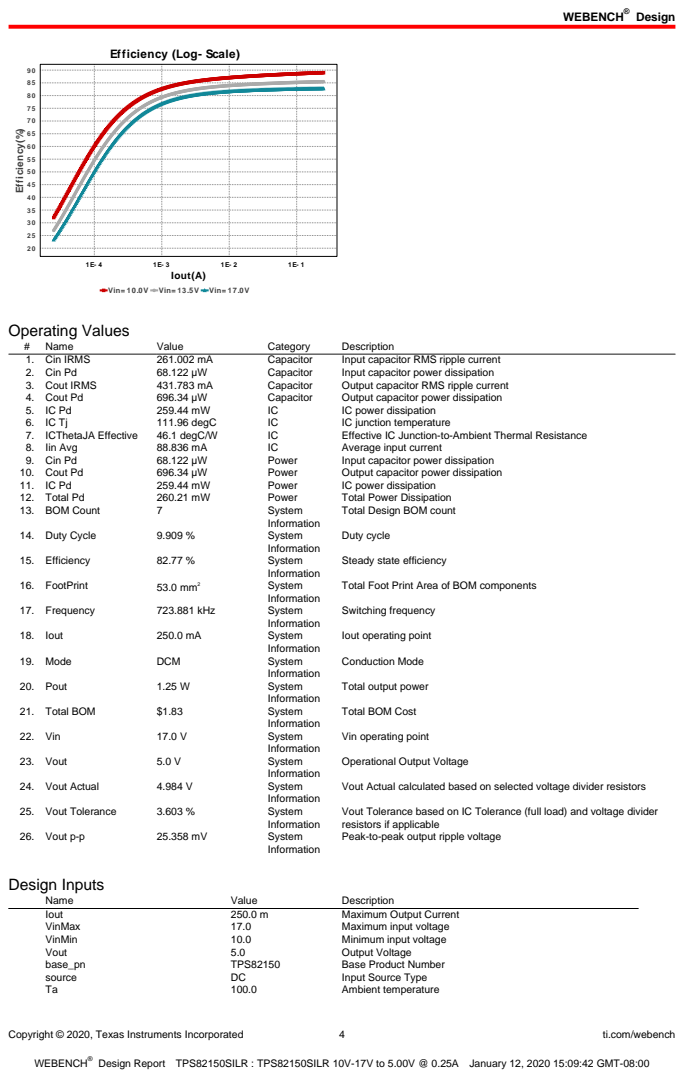
[picture p5: page 4]
Copyright © 2020, Texas Instruments Incorporated; ti.com/webench; Iout(A); Efficiency(%); Operating Values; Name; Value; Category; Description; 1. Cin IRMS; Capacitor; Input capacitor RMS ripple current; 2. Cin Pd; Input capacitor power dissipation; 3. Cout IRMS; Output capacitor RMS ripple current; 4. Cout Pd; Output capacitor power dissipation; IC power dissipation; 111.96 degC; IC junction temperature; 7. ICThetaJA Effective; 46.1 degC/W; Effective IC Junction-to-Ambient Thermal Resistance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

Efficiency (Log- Scale)

Vin= 10.0V Vin= 13.5V Vin= 17.0V

Total Design BOM count

Steady state efficiency

Total Foot Print Area of BOM components

Iout operating point

Total output power

Total BOM Cost

Vin operating point

Operational Output Voltage

Vout Actual calculated based on selected voltage divider resistors

Vout Tolerance based on IC Tolerance (full load) and voltage divider
resistors if applicable
Peak-to-peak output ripple voltage


Copyright © 2020, Texas Instruments Incorporated | 5 | ti.com/webench

## Assembly

## Component Testing

Some published data on components in datasheets such as Capacitor ESR and Inductor DC resistance is based on conservative values that will guarantee that the components always exceed the specification. For design purposes it is usually better to work with typical values. Since this data is not always available it is a good practice to measure the Capacitance and ESR values of Cin and Cout, and the inductance and DC resistance of L1 before assembly of the board. Any large discrepancies in values should be electrically simulated in WEBENCH to check for instabilities and thermally simulated in WebTHERM to make sure critical temperatures are not exceeded.

## Soldering Component to Board

If board assembly is done in house it is best to tack down one terminal of a component on the board then solder the other terminal. For surface mount parts with large tabs, such as the DPAK, the tab on the back of the package should be pre-tinned with solder, then tacked into place by one of the pins. To solder the tab town to the board place the iron down on the board while resting against the tab, heating both surfaces simultaneously. Apply light pressure to the top of the plastic case until the solder flows around the part and the part is flush with the PCB. If the solder is not flowing around the board you may need a higher wattage iron (generally 25W to 30W is enough).

## Initial Startup of Circuit

It is best to initially power up the board by setting the input supply voltage to the lowest operating input voltage 10.0V and set the input supply's current limit to zero. With the input supply off connect up the input supply to Vin and GND. Connect a digital volt meter and a load if needed to set the minimum Iout of the design from Vout and GND. Turn on the input supply and slowly turn up the current limit on the input supply.
If the voltage starts to rise on the input supply continue increasing the input supply current limit while watching the output voltage. If the current increases on the input supply, but the voltage remains near zero, then there may be a short or a component misplaced on the board. Power down the board and visually inspect for solder bridges and recheck the diode and capacitor polarities. Once the power supply circuit is operational then more extensive testing may include full load testing, transient load and line tests to compare with simulation results.

## Load Testing

The setup is the same as the initial startup, except that an additional digital voltmeter is connected between Vin and GND, a load is connected between Vout and GND and a current meter is connected in series between Vout and the load. The load must be able to handle at least rated output power + 50% ( 7.5 watts for this design). Ideally the load is supplied in the form of a variable load test unit. It can also be done in the form of suitably large power resistors. When using an oscilloscope to measure waveforms on the prototype board, the ground leads of the oscilloscope probes should be as short as possible and the area of the loop formed by the ground lead should be kept to a minimum. This will help reduce ground lead inductance and eliminate EMI noise that is not actually present in the circuit.

## Design Assistance

1. Feature Highlights: DCS-Control(TM) Architecture with up to 3A output current, Power module with integrated inductor, 3V to 17V Input Voltage Range, Adjustable output voltage from 0.9V to 5V, Optional softstart capacitor for slow startup, Power Save Mode for light load efficiency, 100% duty cycle for lowest dropout, PG=Low when device is in shutdown through EN or Thermal Shutdown
2. Master key : 6CCD1BA7C78FEA40[v1]
3. TPS82150 Product Folder : http://www.ti.com/product/TPS82150 : contains the data sheet and other resources.

Copyright © 2020, Texas Instruments Incorporated | 6 | ti.com/webench

Important Notice and Disclaimer

TI provides technical and reliability data (including datasheets), design resources (including reference designs), application or other design advice, web tools, safety information, and other resources AS IS and with all faults, and disclaims all warranties. These resources are intended for skilled developers designing with TI products. You are solely responsible for (1) selecting the appropriate TI products for your application, (2) designing, validating and testing your application, and (3) ensuring your application meets applicable standards, and any other safety, security, or other requirements.

These resources are subject to change without notice. TI grants you permission to use these resources only for development of an application that uses the TI products described in the resource. Other reproduction and display of these resources is prohibited. No license is granted to any other TI intellectual property right or to any third party intellectual property right. TI disclaims responsibility for, and you will fully indemnify TI and its representatives against, any claims, damages, costs, losses, and liabilities arising out of your use of these resources.

Providing these resources does not expand or otherwise alter TI's applicable Terms of Sale or other applicable terms available either on ti.com or provided in conjunction with TI products.
