plmwd/HKN-SAE-Project/Board/schematic_rev1.1.pdf

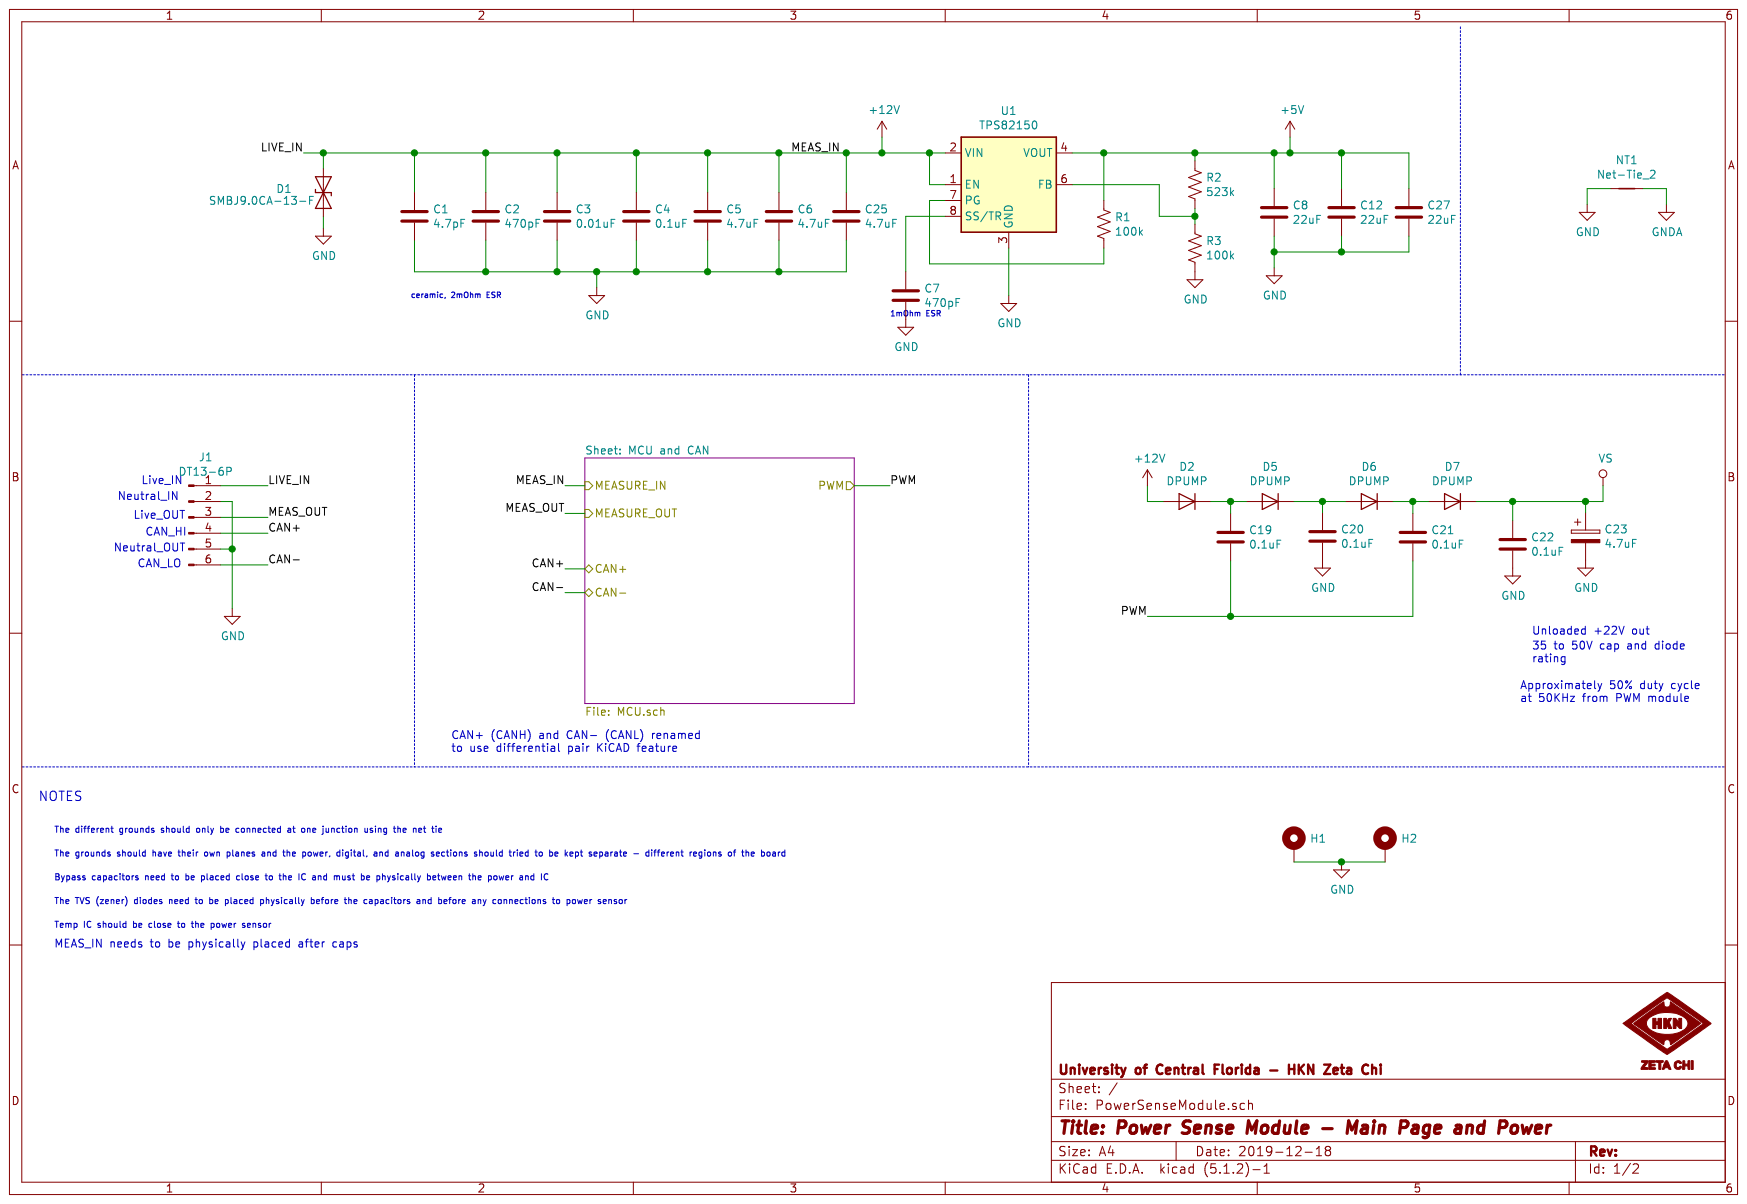
[picture p11: page 1]

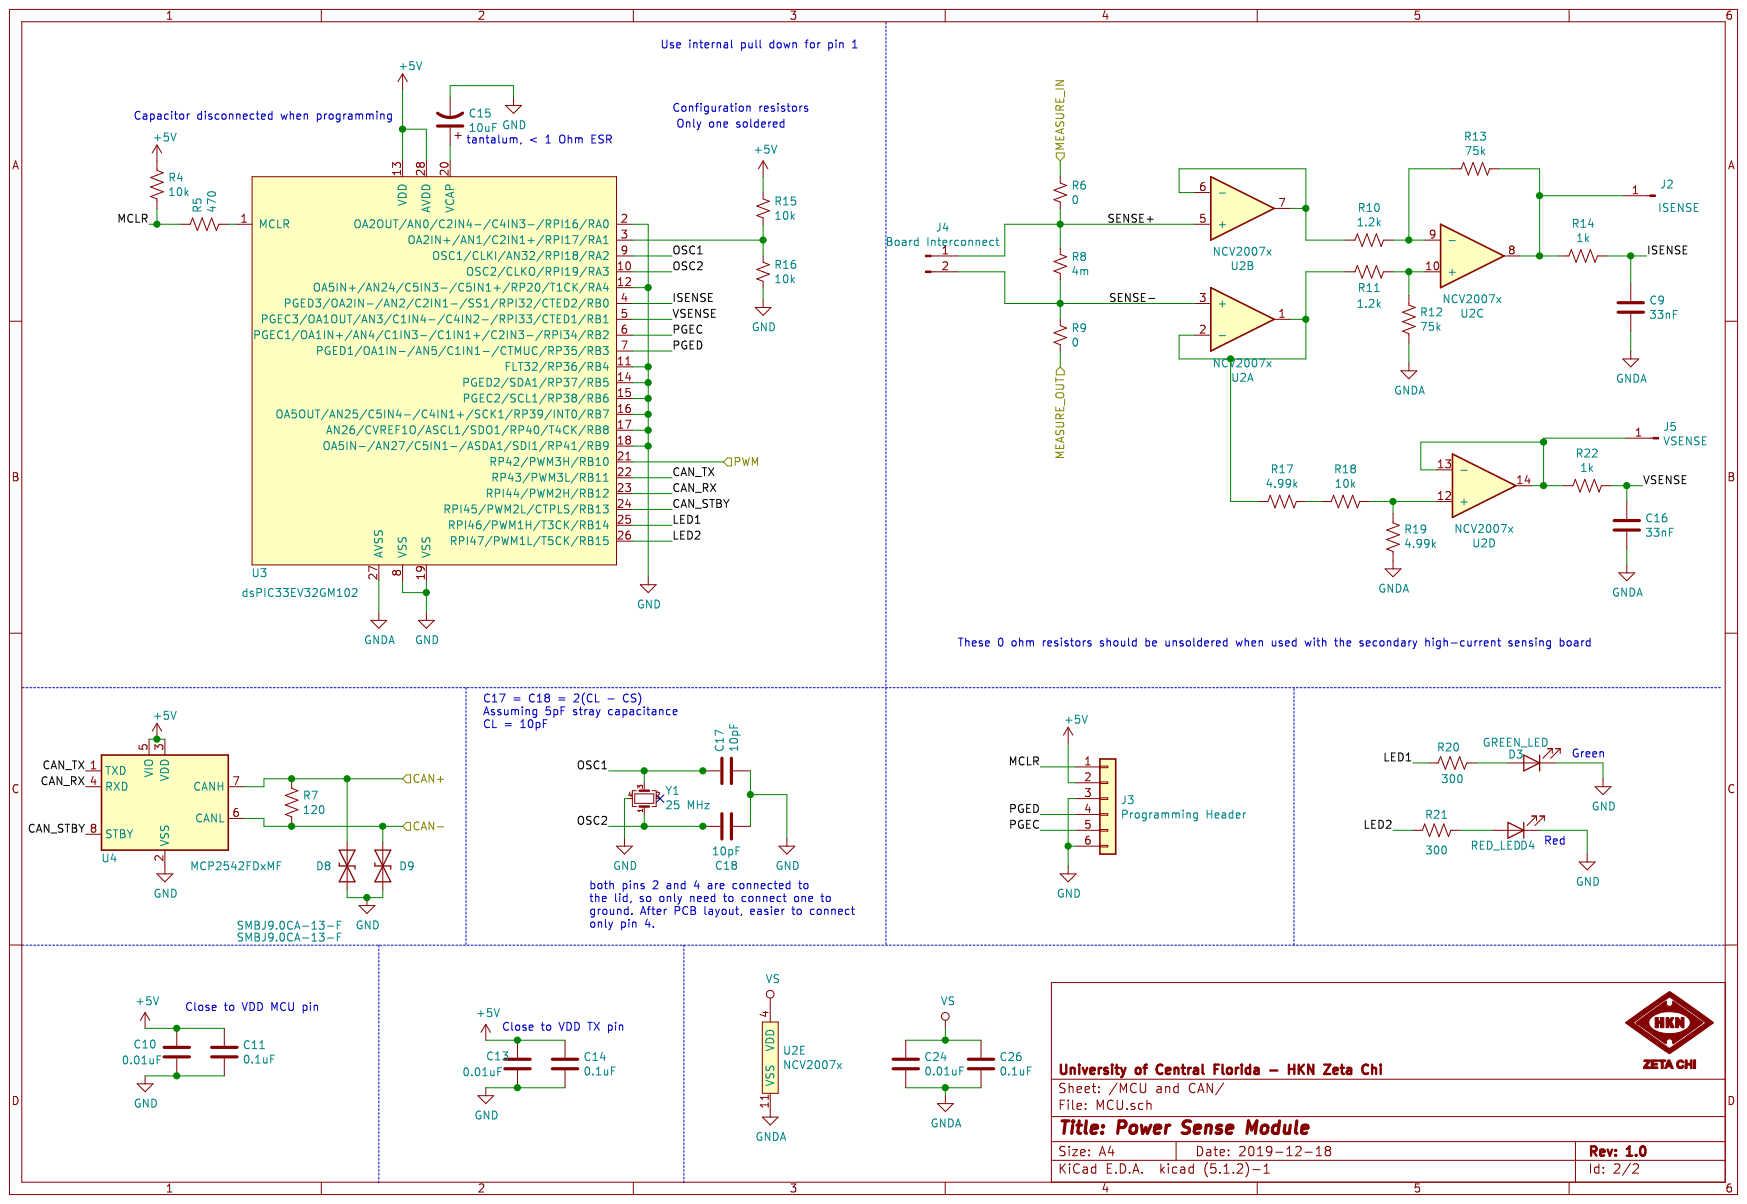
[picture p12: page 2]
