plmwd/HKN-SAE-Project/Design Files/schematic8232019.pdf

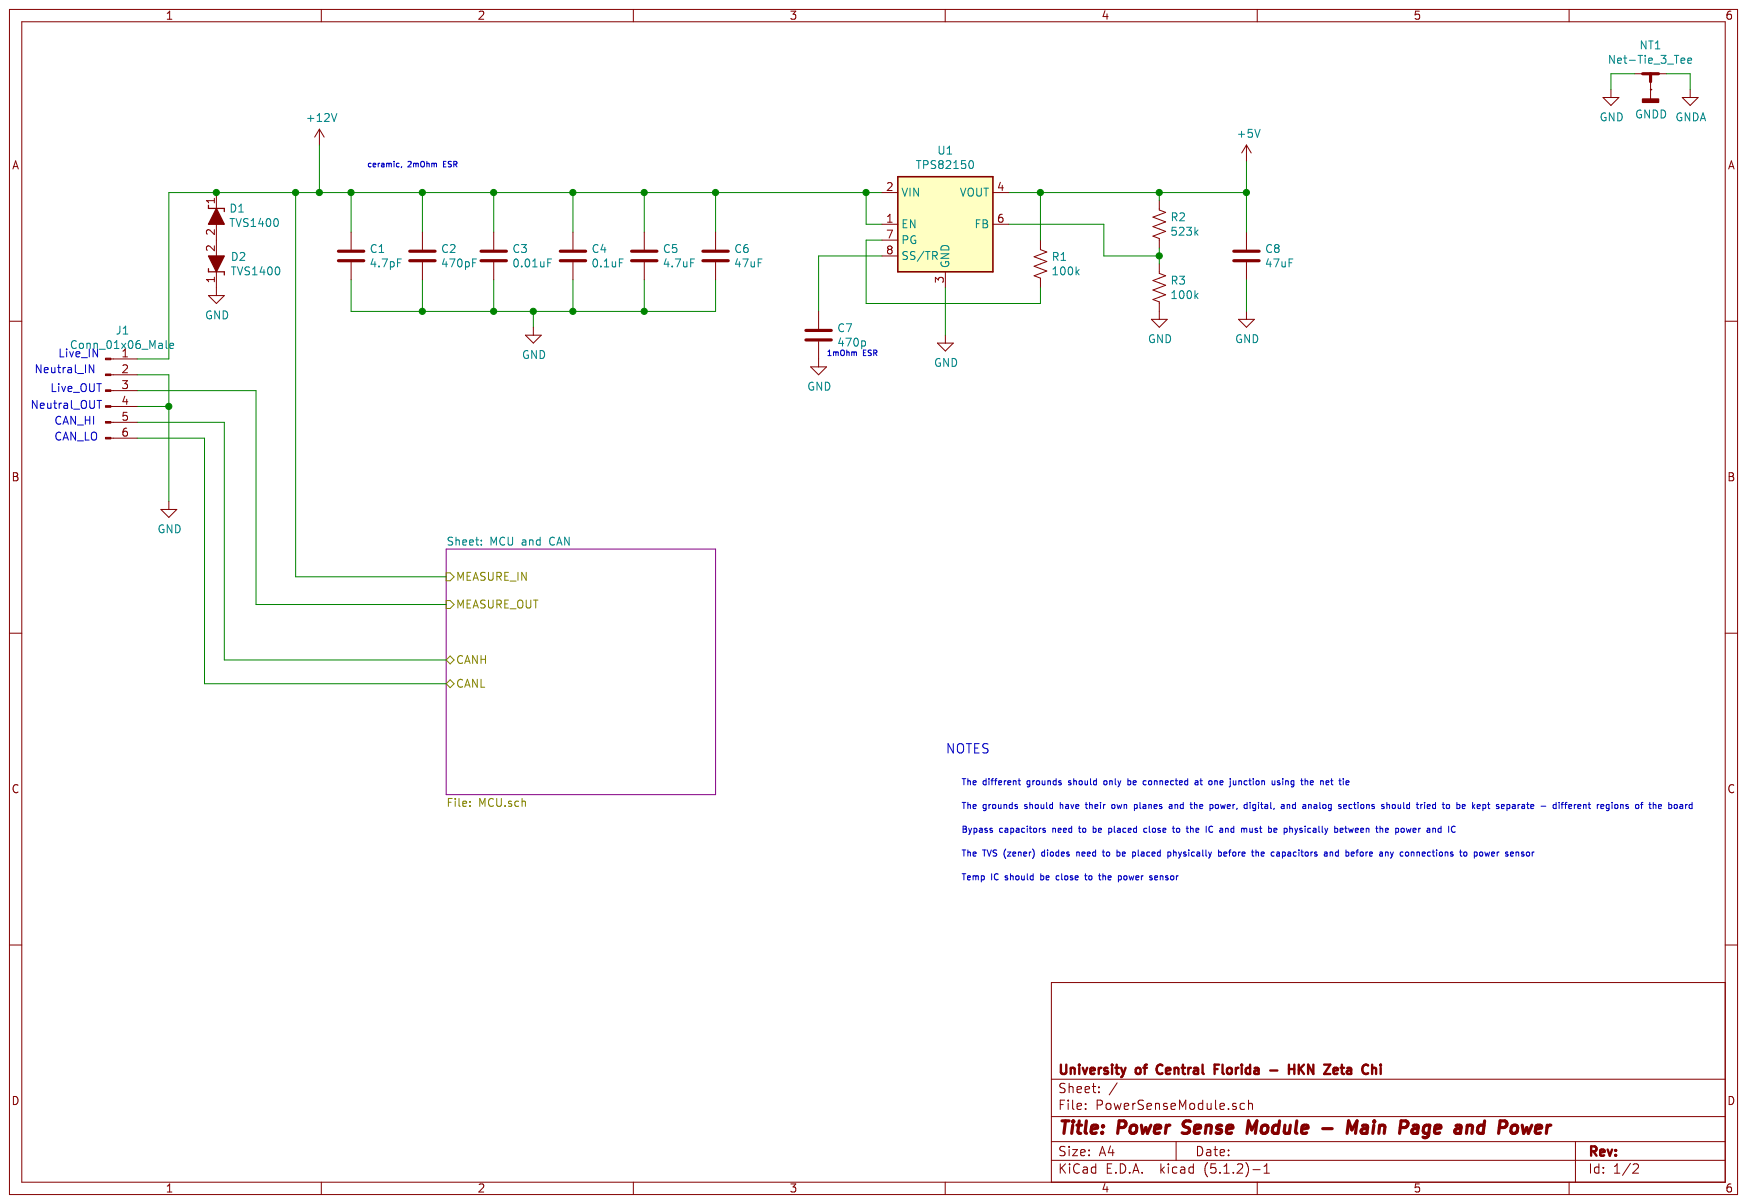
[picture p13: page 1]

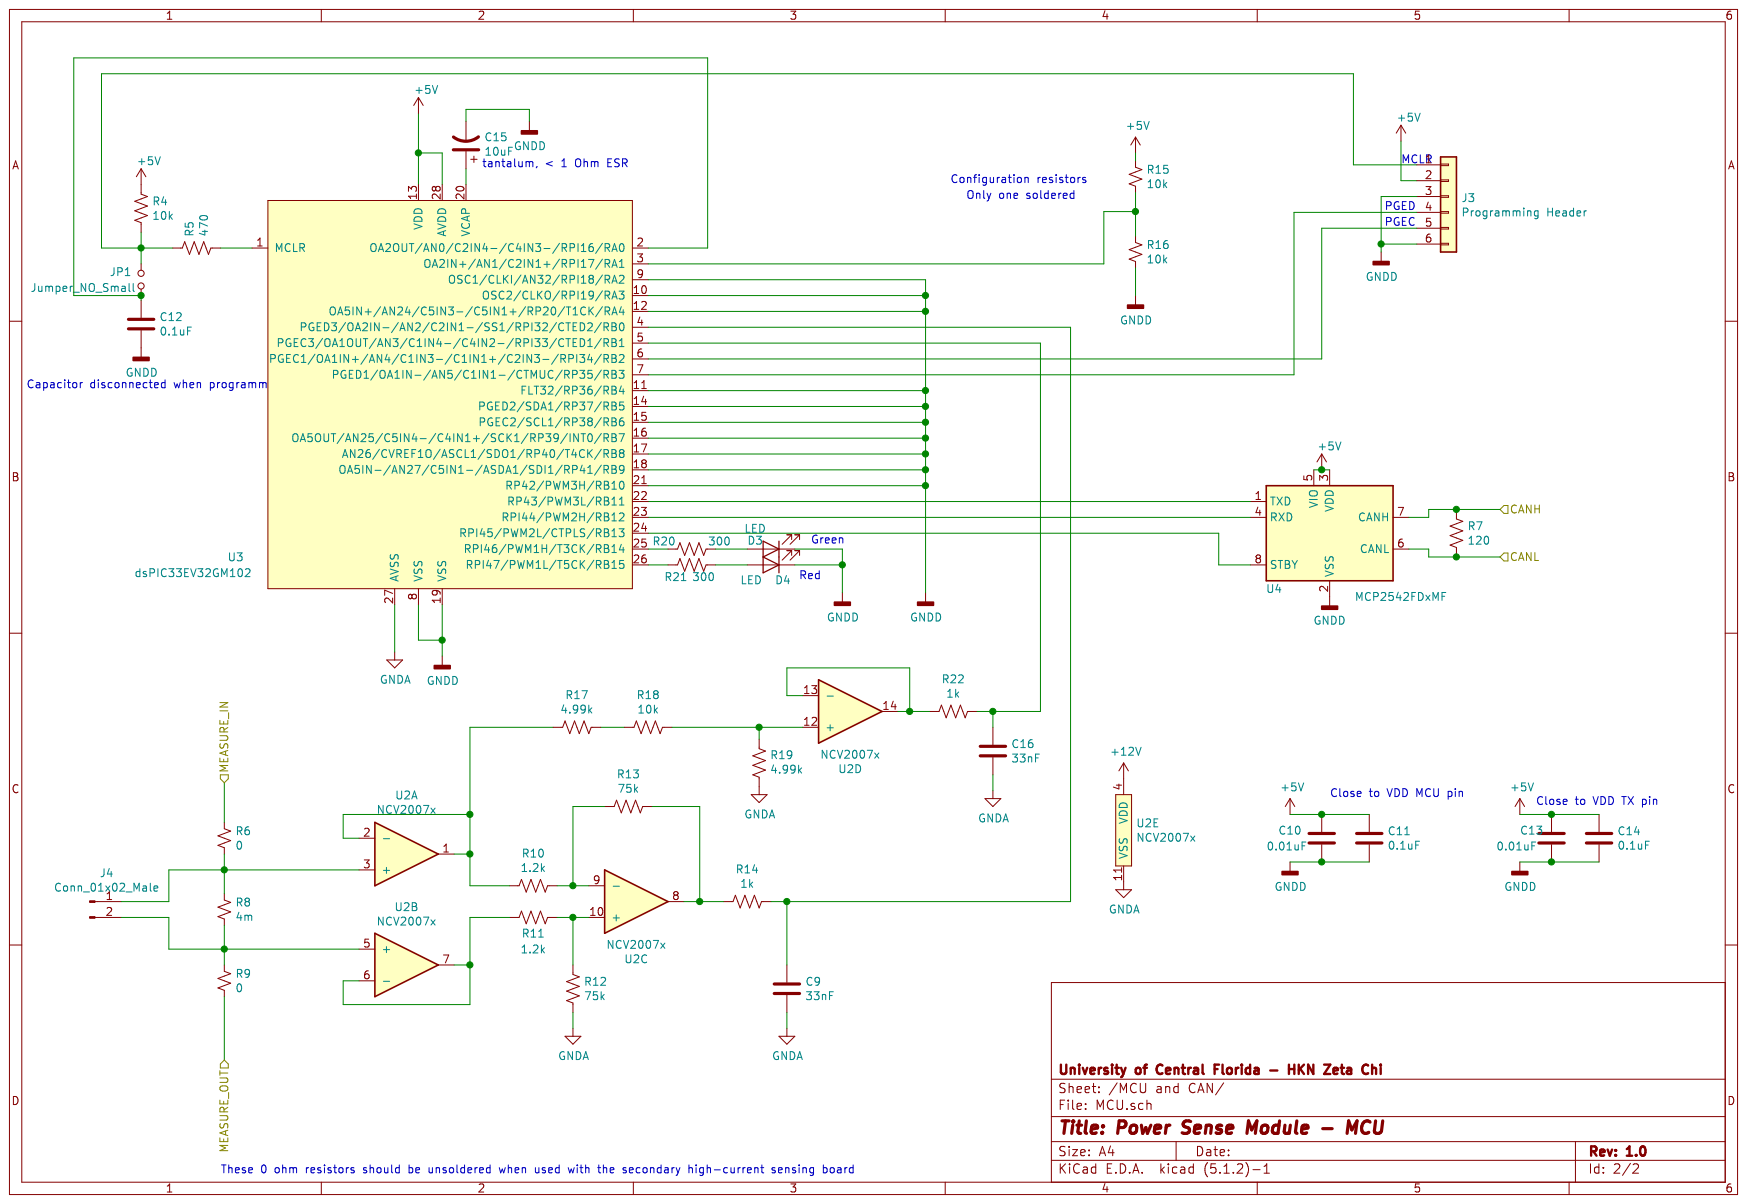
[picture p14: page 2]
