plmwd/HKN-SAE-Project/Board/PowerSenseModule/bom/PowerSenseModule-Order-TE.pdf

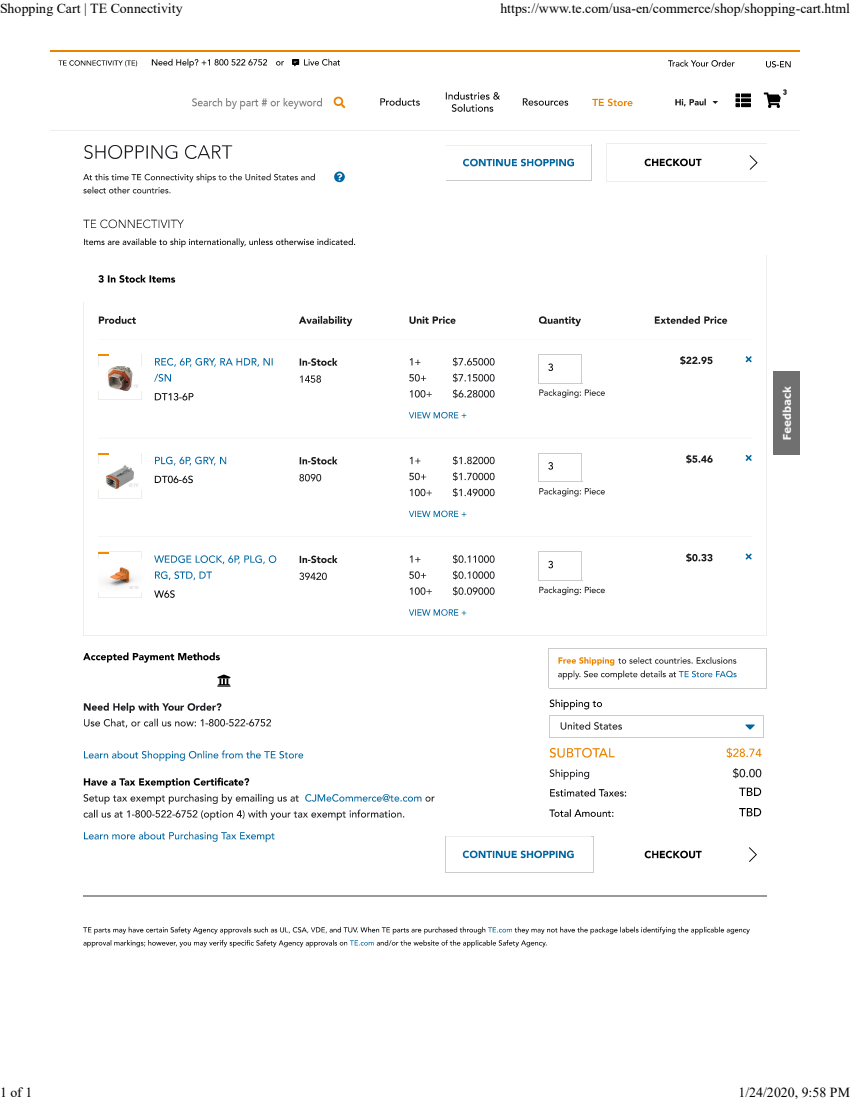
[picture p15: page 1]
Shopping Cart | TE Connectivity; https://www.te.com/usa-en/commerce/shop/shopping-cart.html
