plmwd/HKN-SAE-Project/Board/pcb_rev1.1.pdf

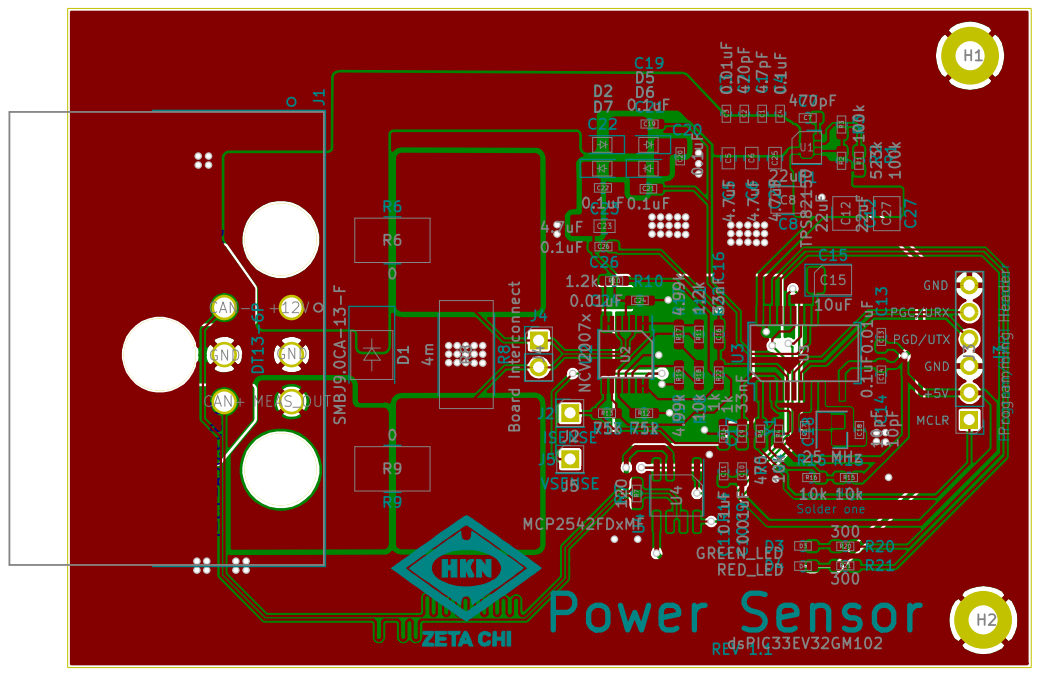
[picture p16: page 1]
