plmwd/HKN-SAE-Project/Board/rev1.0.pdf

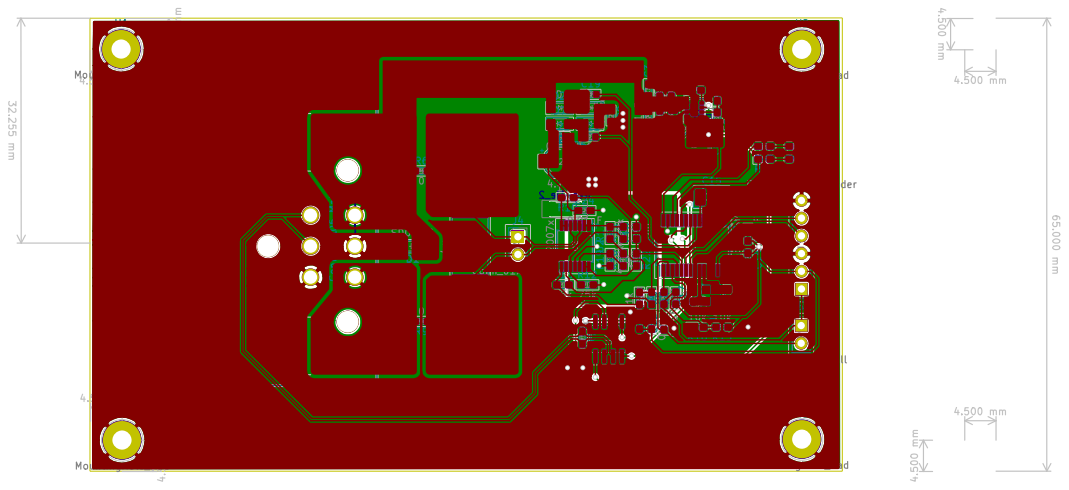
[picture p17: page 1]
