plmwd/HKN-SAE-Project/Board/PowerSenseModule/fab/PowerSenseModule_FabDrawings_wCopper.pdf

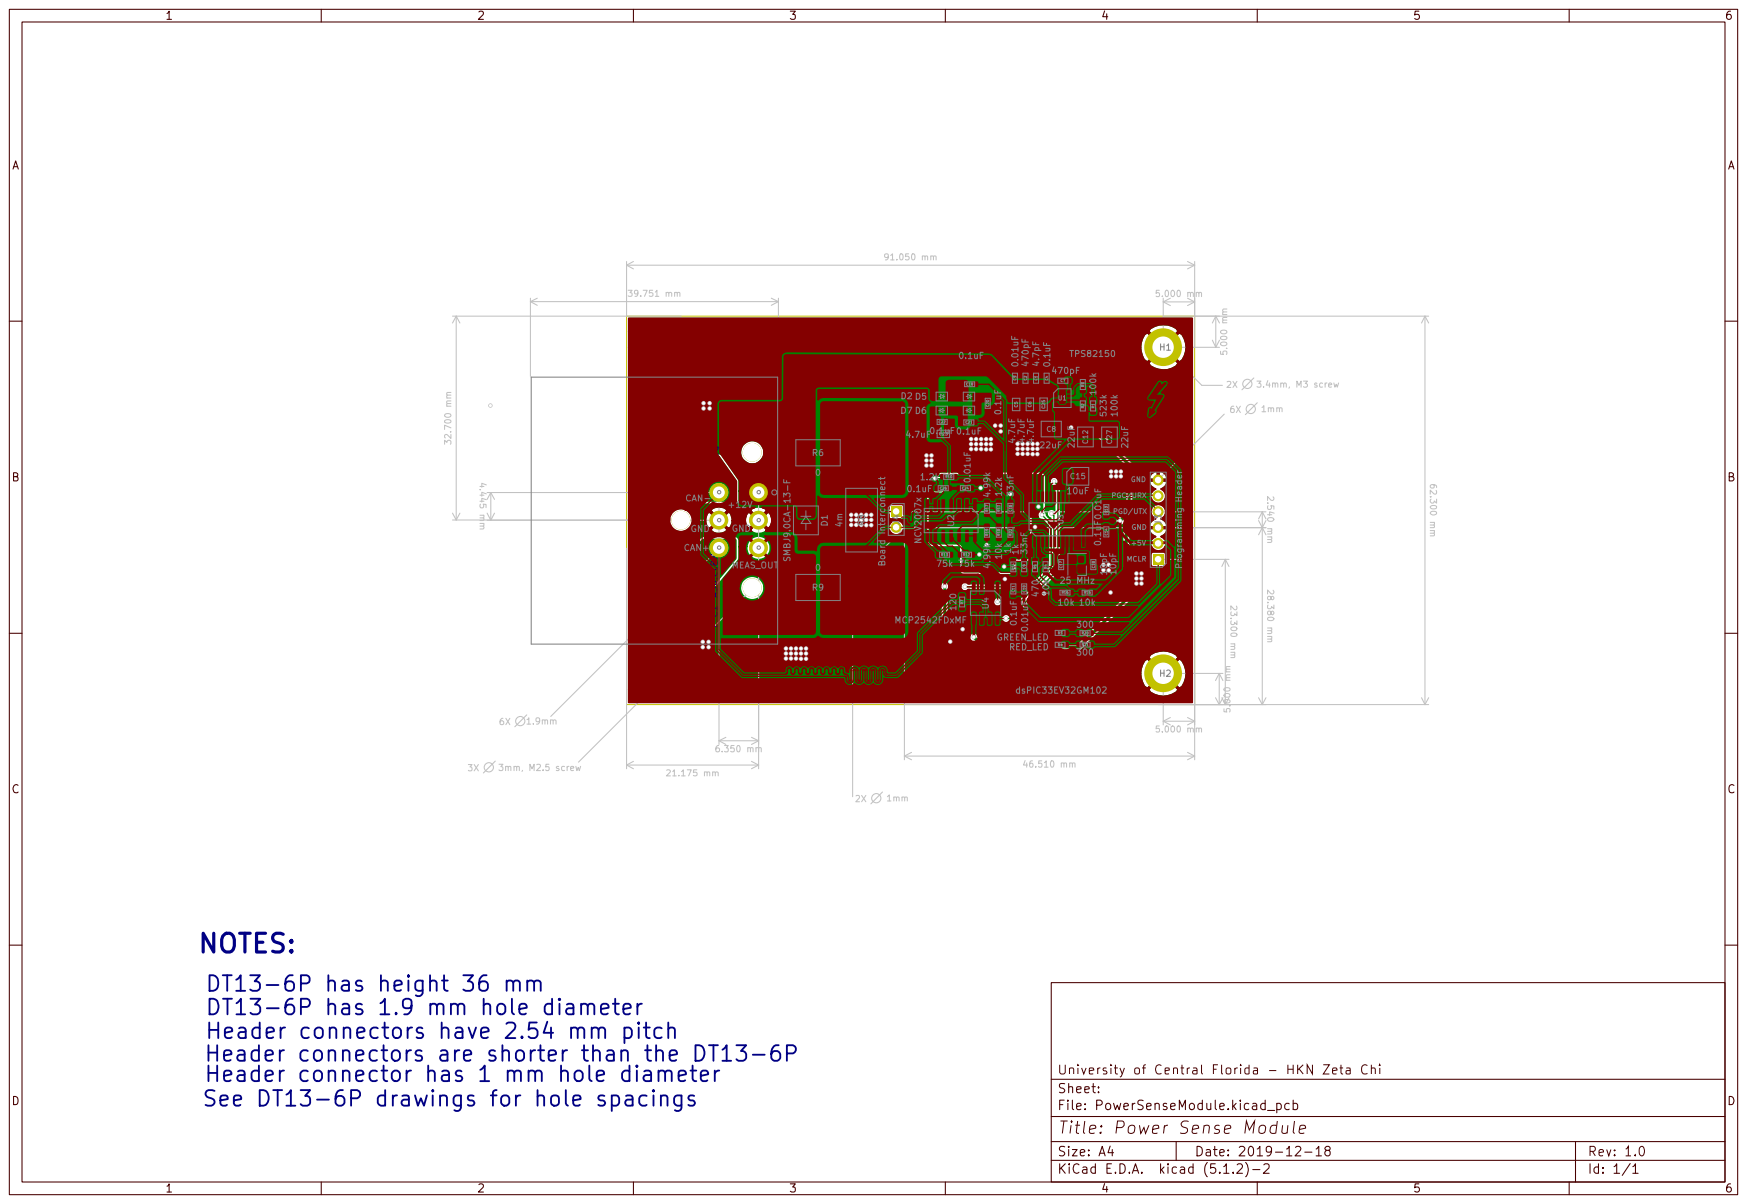
[picture p18: page 1]
