plmwd/HKN-SAE-Project/Board/PowerSenseModule/fab/PowerSenseModule_FabDrawings.pdf

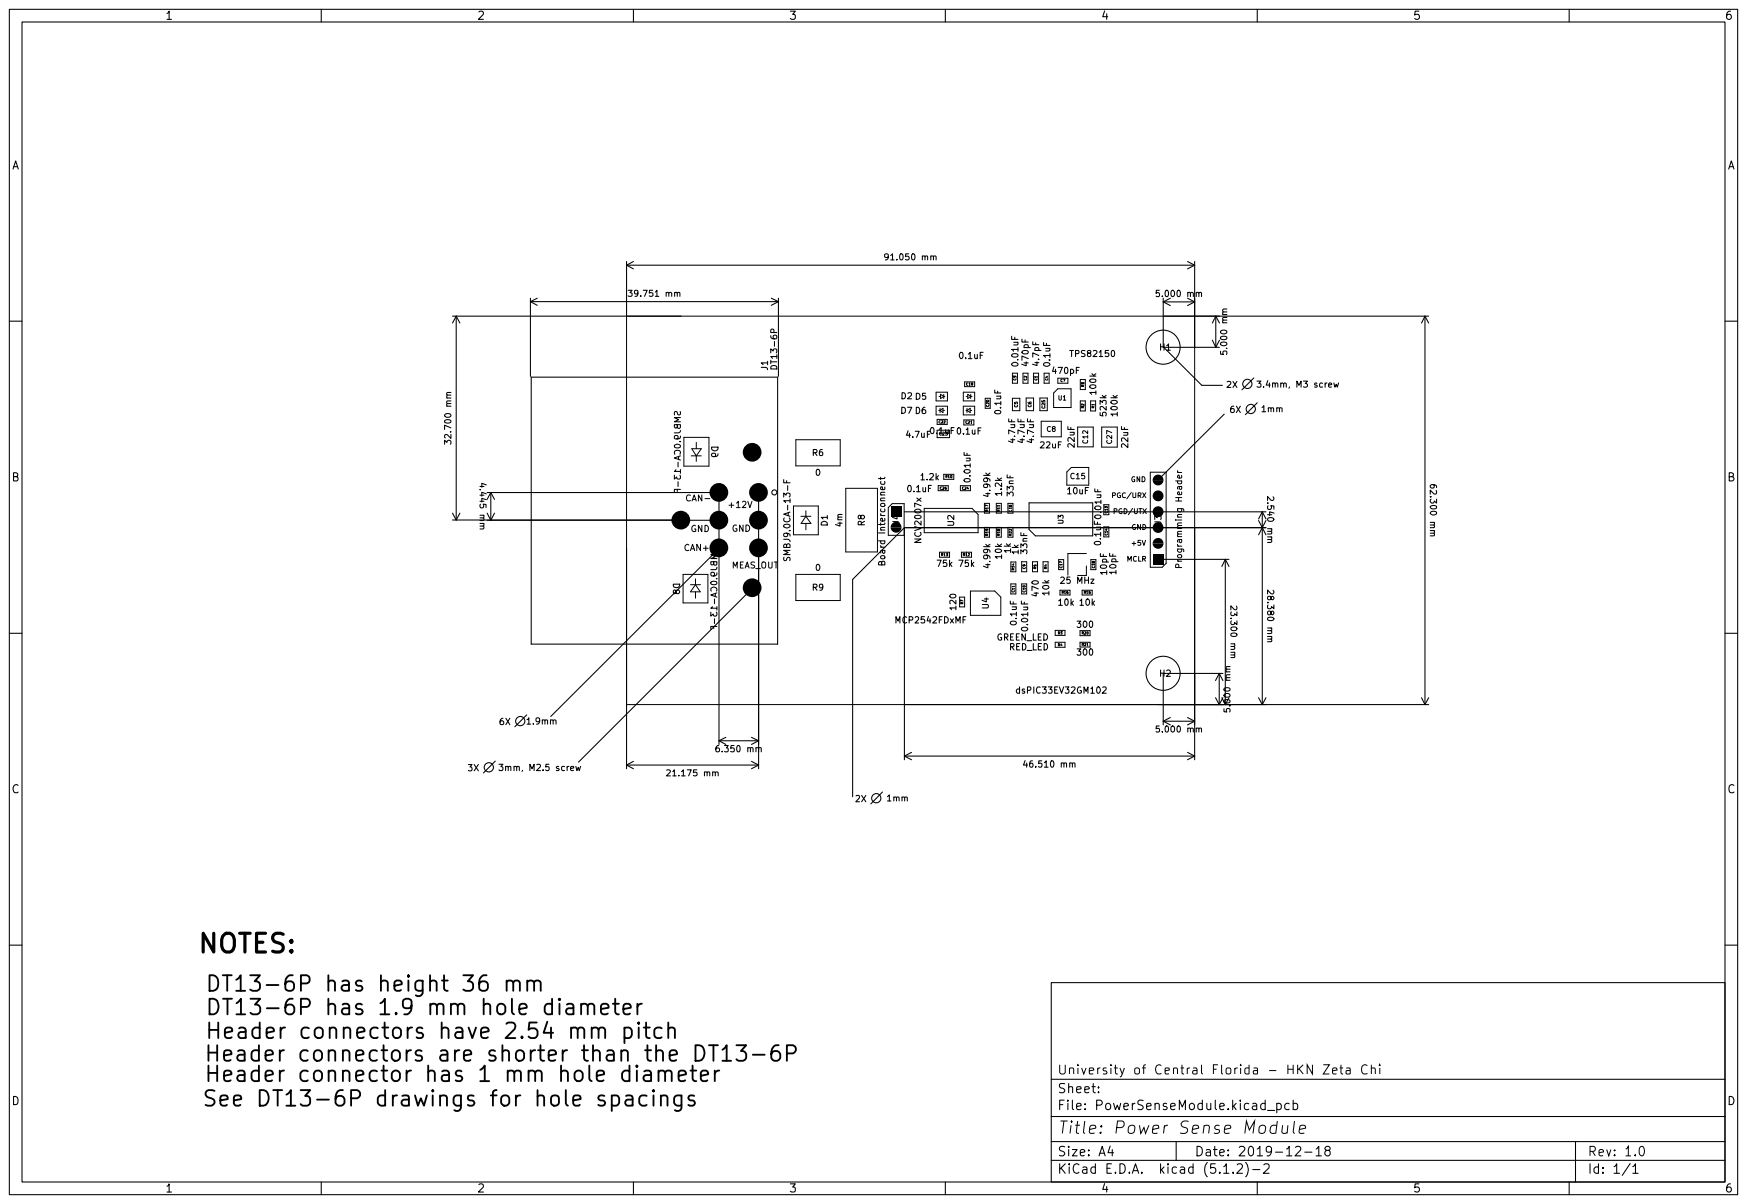
[picture p19: page 1]
