plmwd/HKN-SAE-Project/Board/schematic_rev1.0.pdf

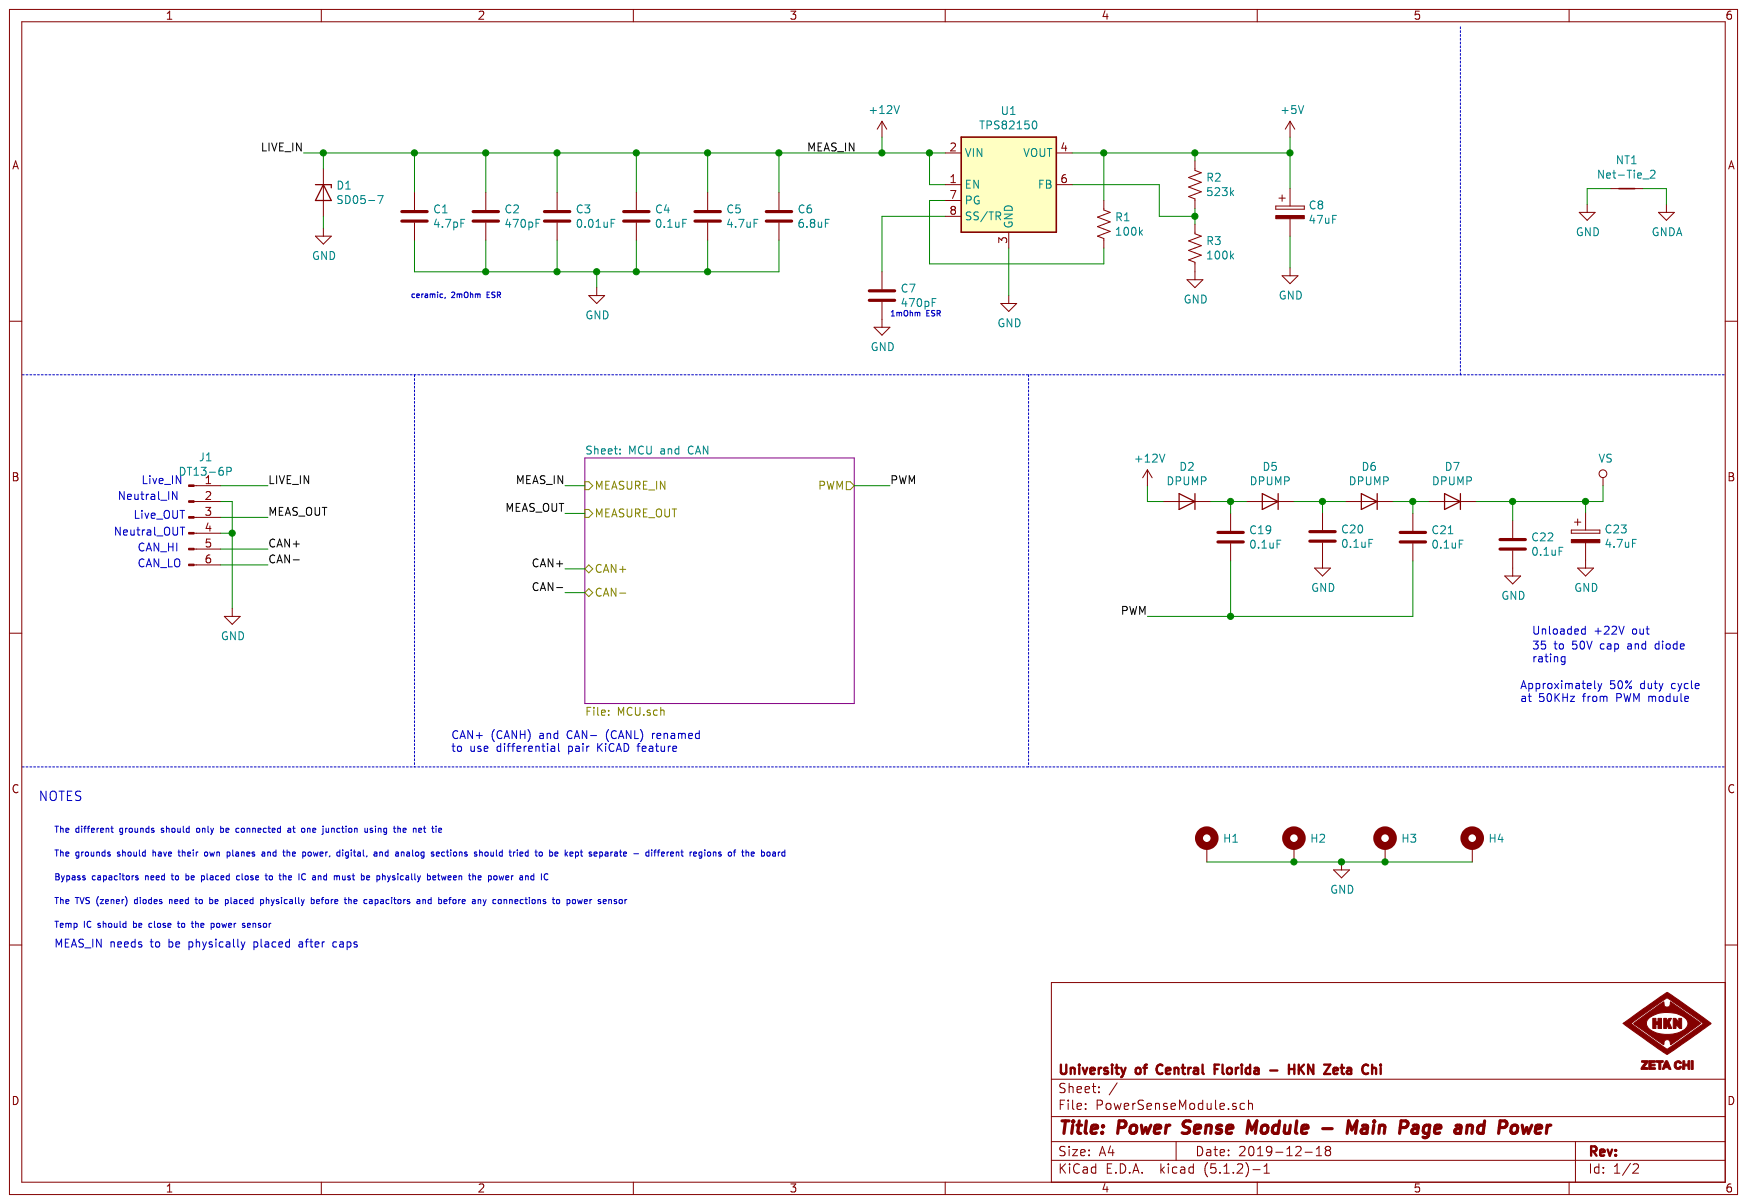
[picture p20: page 1]

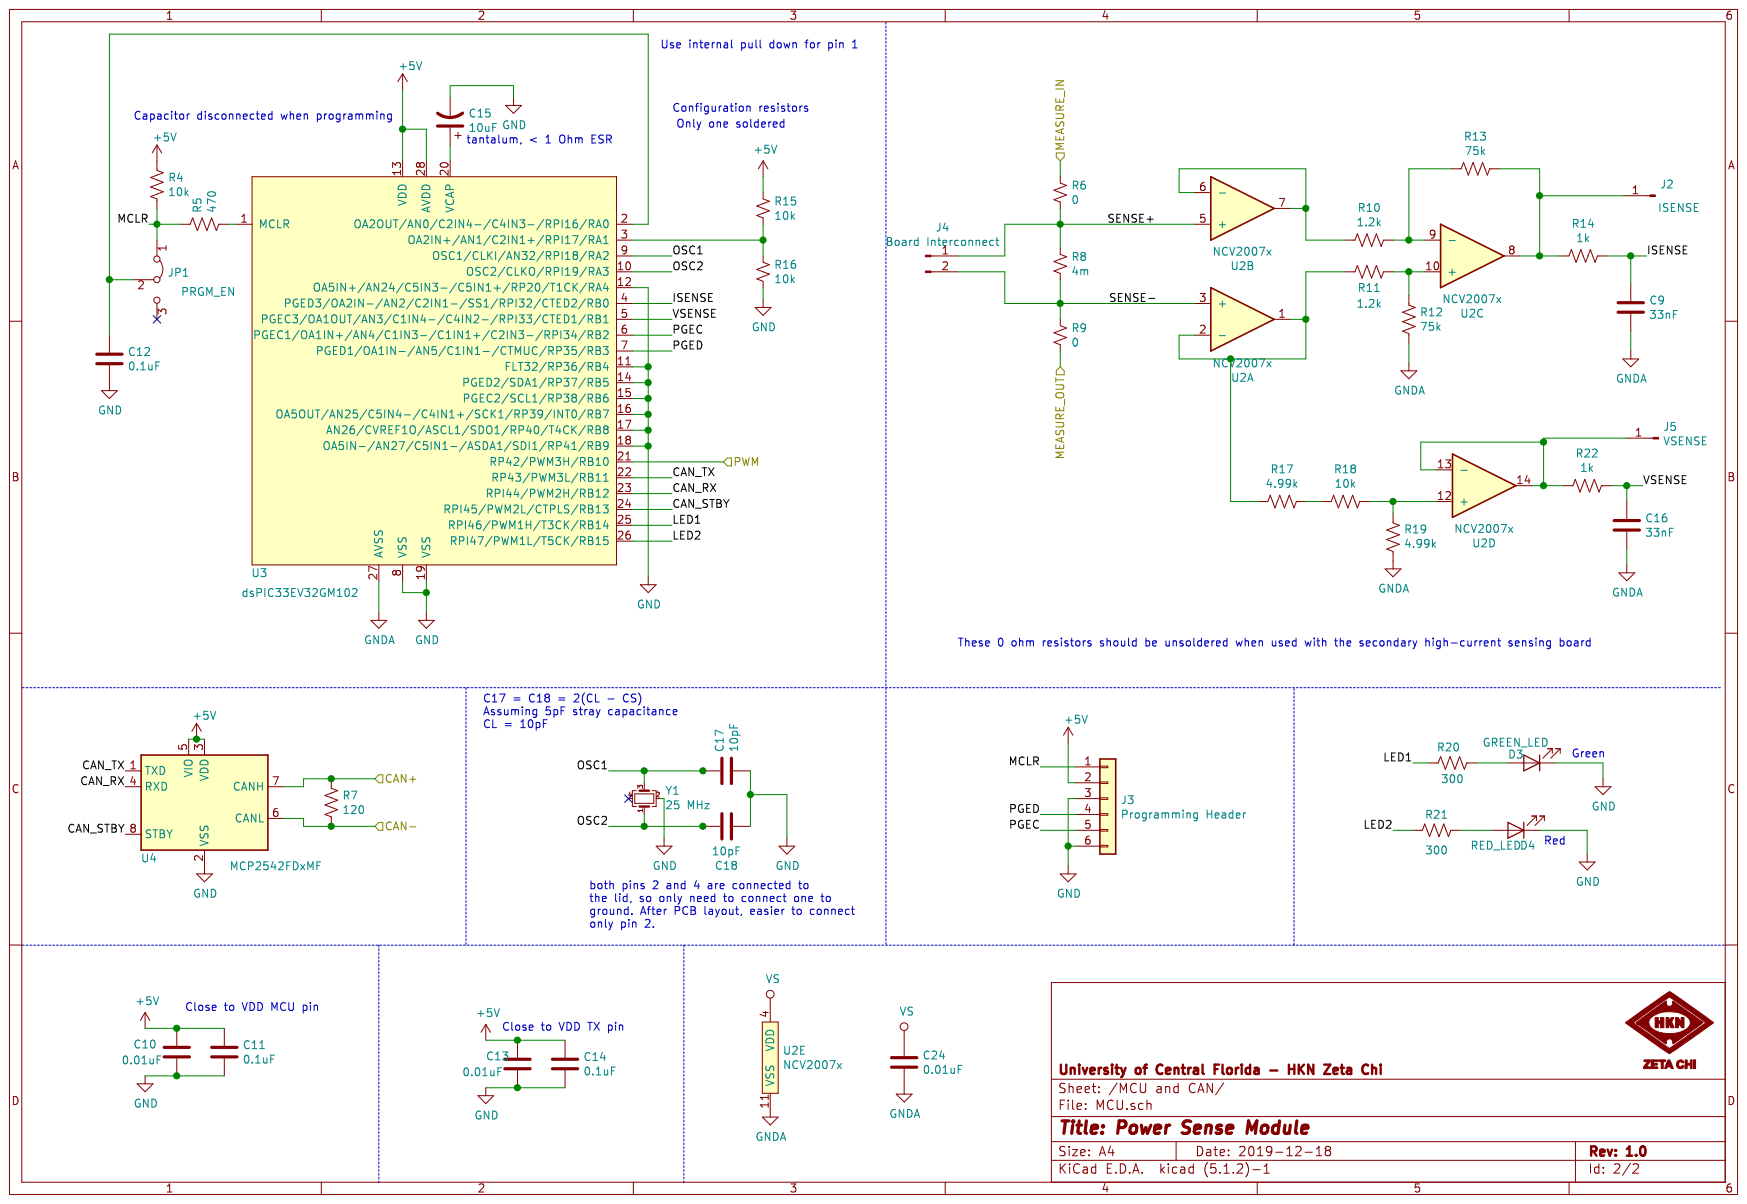
[picture p21: page 2]
