plmwd/HKN-SAE-Project/Board/PowerSenseModule/PowerSenseModule.kicad_pcb

## KiCad design Board/PowerSenseModule/PowerSenseModule.kicad_pcb (2020-01-22)

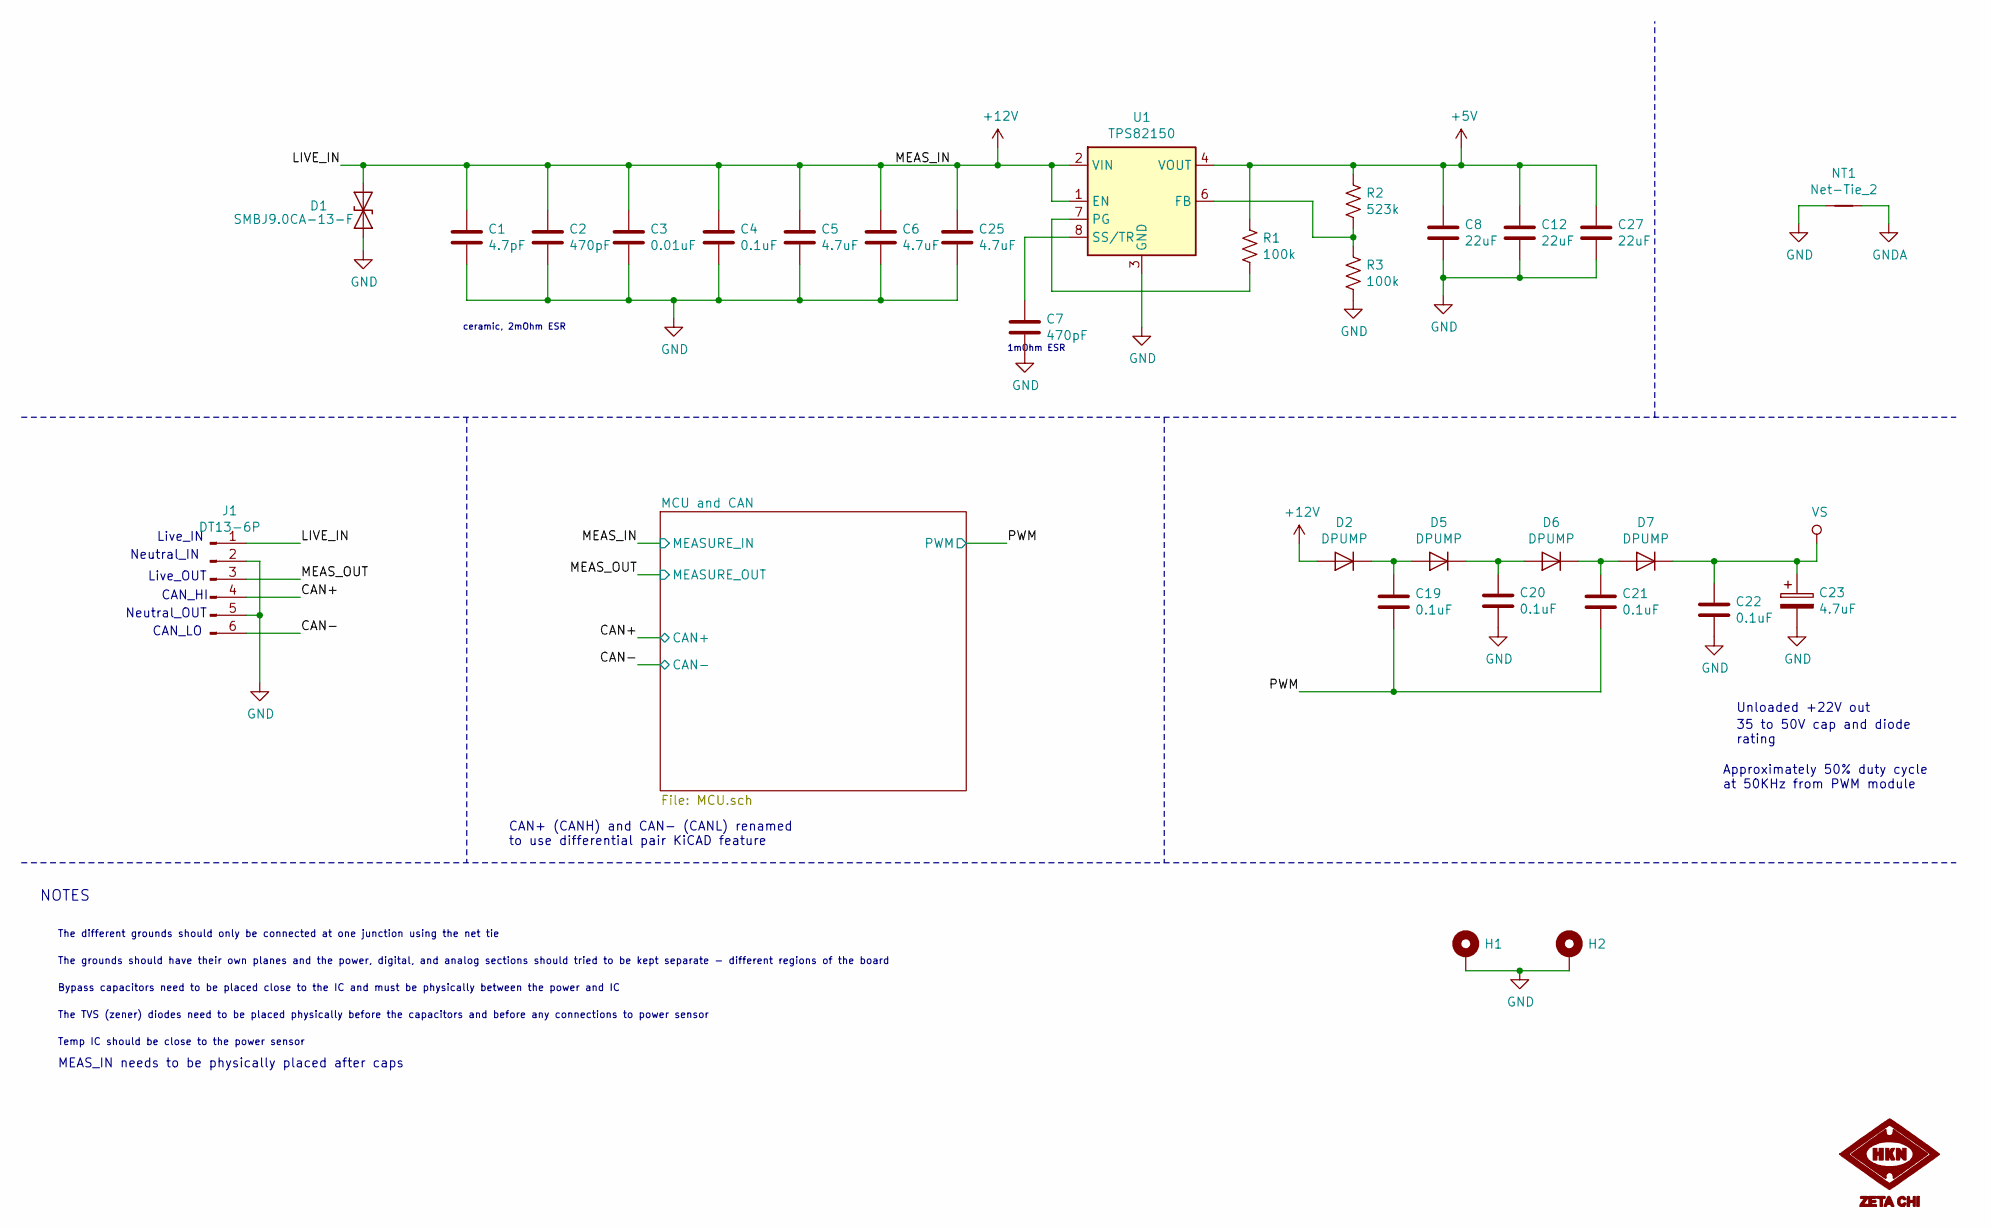
[picture p22: schematic PowerSenseModule.sch, Power Sense Module - Main Page and Power]

Parts:
C1: 4.7pF; C_0603_1608Metric_Pad1.05x0.95mm_HandSolder; Manufacturer PN C0603X479C1HACTU
C2, C7: 470pF; C_0603_1608Metric_Pad1.05x0.95mm_HandSolder; Manufacturer PN C0603C471J5GAC7411
C3: 0.01uF; C_0603_1608Metric_Pad1.05x0.95mm_HandSolder; Manufacturer PN C0603C103J5RACTU
C4, C19, C20, C21, C22: 0.1uF; C_0603_1608Metric_Pad1.05x0.95mm_HandSolder; Manufacturer PN CGA3E2X7R1H104K080AA
C5, C6, C23, C25: 4.7uF; C_0805_2012Metric_Pad1.15x1.40mm_HandSolder; Manufacturer PN GRM21BC81H475KE11L
C8, C12, C27: 22uF; C_1210_3225Metric_Pad1.42x2.65mm_HandSolder; Manufacturer PN CL32B226MOJNNNE
D1: SMBJ9.0CA-13-F; D_SMB_Handsoldering; Manufacturer PN SMBJ9.0CA-13-F
D2, D5, D6, D7: DPUMP; D_SOD-323_HandSoldering; Manufacturer PN CUS10S30,H3F
G1: LOGO; HKNZetaChi
H1, H2: MountingHole_2.7mm_M2.5_Pad
J1: DT13-6P; Manufacturer PN DT13-6P
NT1: Net-Tie_2; NetTie-2_SMD_Pad2.0mm
R1, R3: 100k; R_0603_1608Metric_Pad1.05x0.95mm_HandSolder; Manufacturer PN CRCW0603100KFKEA
R2: 523k; R_0603_1608Metric_Pad1.05x0.95mm_HandSolder; Manufacturer PN CR0603-FX-5233ELF
U1: TPS82150; Texas_SIL0008D_MicroSiP-8-1EP_2.8x3mm_P0.65mm_EP1.1x1.9mm; Manufacturer PN TPS82150SILR

Connections:
+5V: C8.1, C12.1, C27.1, R1.1, R2.1, U1.4 (VOUT), U1.5 (VOUT); also elsewhere on the board
+12V: C1.1, C2.1, C3.1, C4.1, C5.1, C6.1, C25.1, D1.1 (A1), D2.2 (A), J1.1, U1.1 (EN), U1.2 (VIN); also elsewhere on the board
/CAN+: J1.4; also elsewhere on the board
/CAN-: J1.6; also elsewhere on the board
/MEAS_OUT: J1.3; also elsewhere on the board
/PWM: C19.2, C21.2; also elsewhere on the board
GND: C1.2, C2.2, C3.2, C4.2, C5.2, C6.2, C7.2, C8.2, C12.2, C20.2, C22.2, C23.2, C25.2, C27.2, D1.2 (A2), H1.1, H2.1, J1.2, J1.5, NT1.1, R3.2, U1.3 (GND), U1.9 (GND); also elsewhere on the board
GNDA: NT1.2; also elsewhere on the board
unnamed: C7.1, U1.8 (SS/TR)
unnamed: C19.1, D2.1 (K), D5.2 (A)
unnamed: C20.1, D5.1 (K), D6.2 (A)
unnamed: C21.1, D6.1 (K), D7.2 (A)
unnamed: R1.2, U1.7 (PG)
unnamed: R2.2, R3.1, U1.6 (FB)
VS: C22.1, C23.1, D7.1 (K); also elsewhere on the board

Notes on the sheet:
Neutral_OUT
Live_OUT
Neutral_IN
Live_IN
NOTES
The grounds should have their own planes and the power, digital, and analog sections should tried to be kept separate - different regions of the board
Bypass capacitors need to be placed close to the IC and must be physically between the power and IC
The TVS (zener) diodes need to be placed physically before the capacitors and before any connections to power sensor
The different grounds should only be connected at one junction using the net tie
Temp IC should be close to the power sensor
1mOhm ESR
ceramic, 2mOhm ESR
CAN_HI
CAN_LO
Unloaded +22V out
35 to 50V cap and diode rating
MEAS_IN needs to be physically placed after caps
Approximately 50% duty cycle at 50KHz from PWM module
CAN+ (CANH) and CAN- (CANL) renamed to use differential pair KiCAD feature

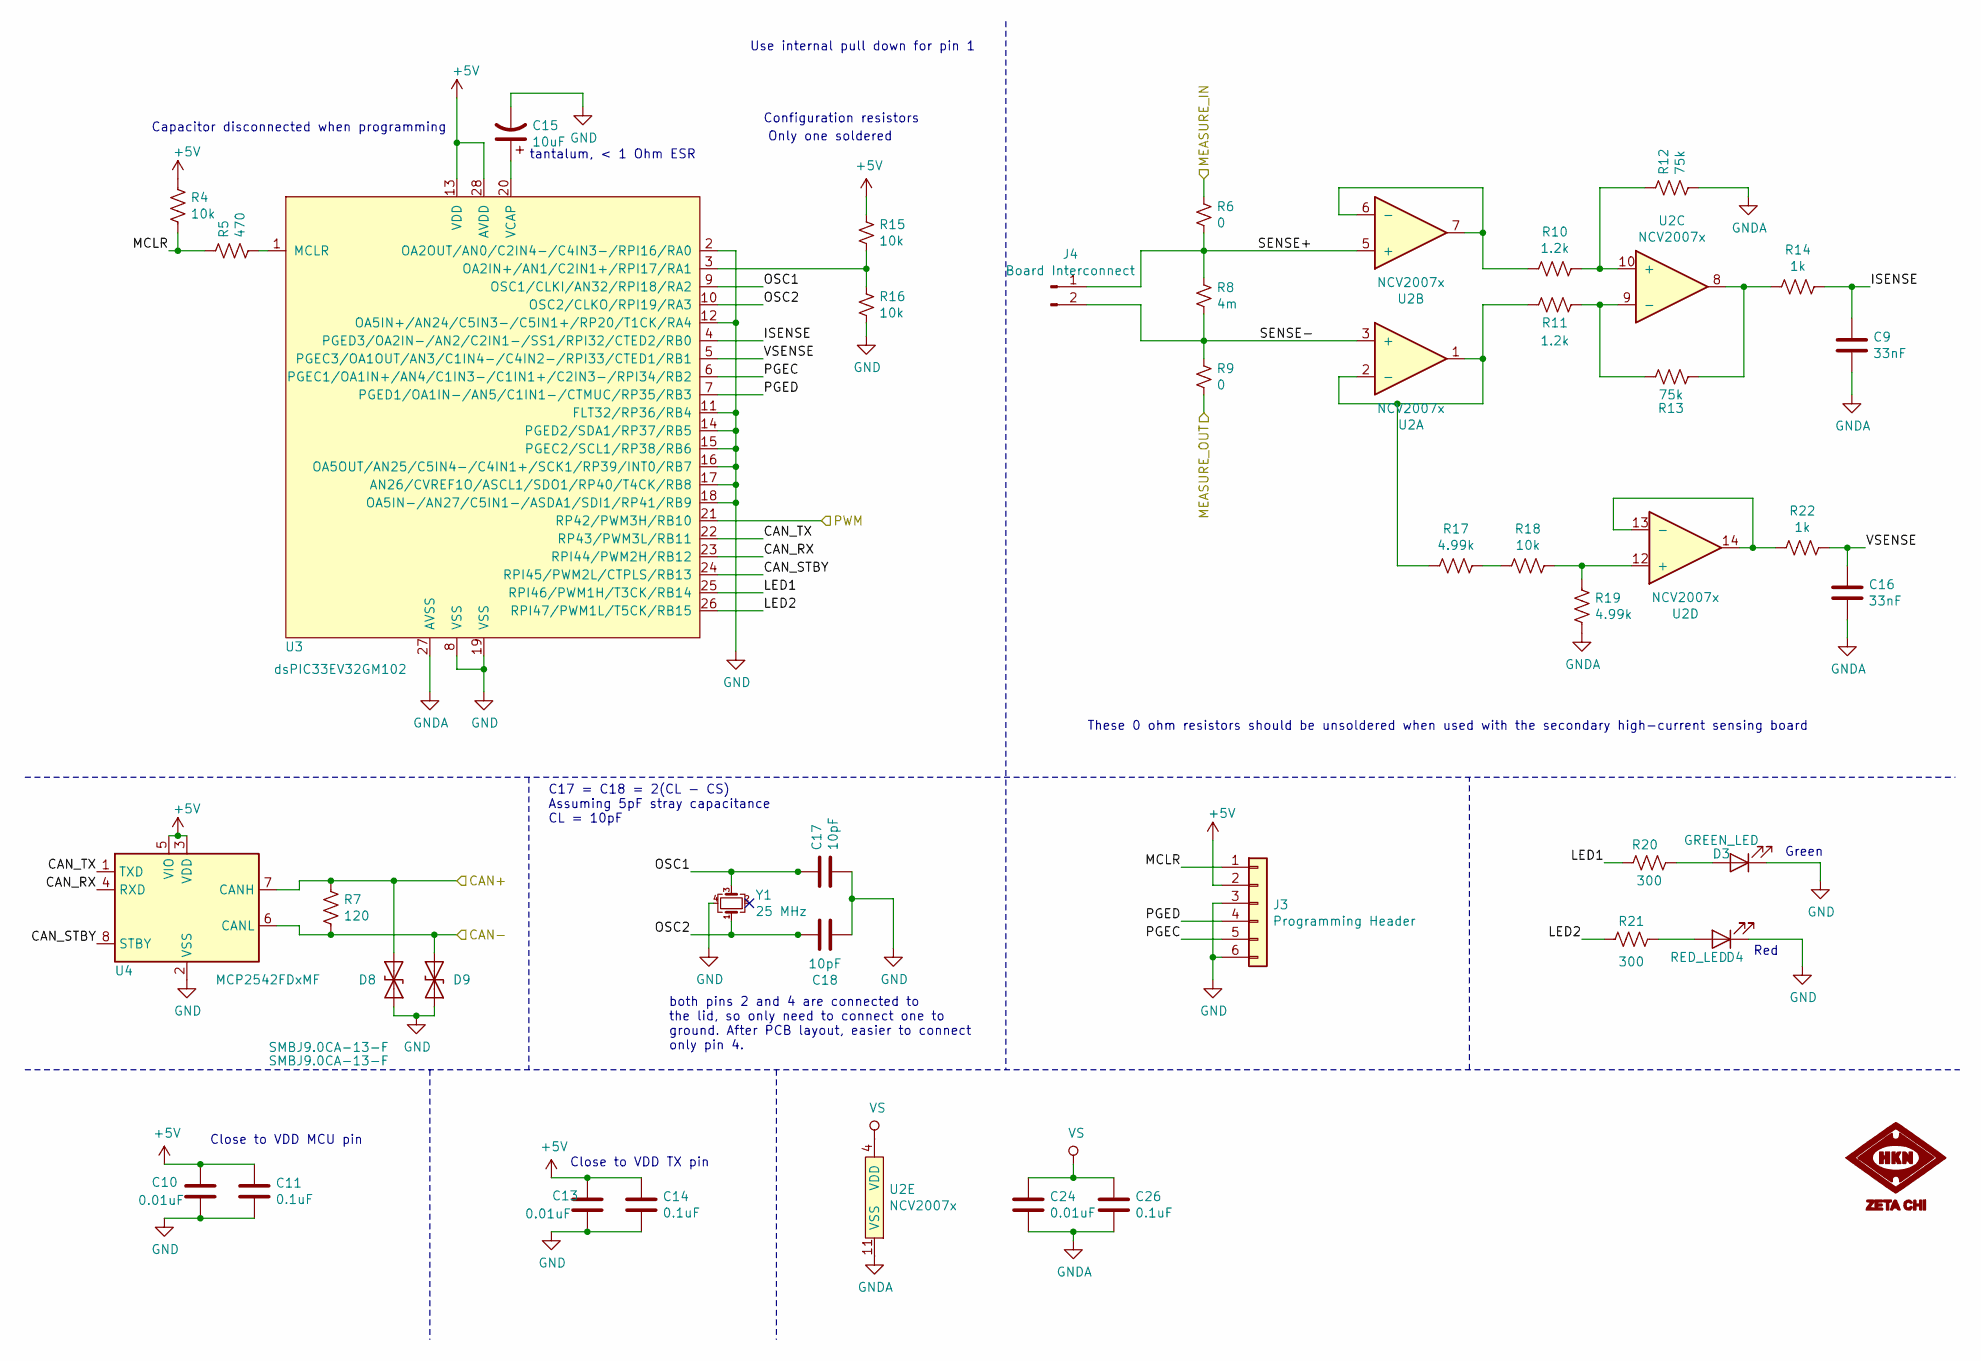
[picture p23: schematic MCU.sch, Power Sense Module]

Parts:
C9, C16: 33nF; C_0603_1608Metric_Pad1.05x0.95mm_HandSolder; Manufacturer PN CGA3E2X7R1H333M080AA
C10, C13, C24: 0.01uF; C_0603_1608Metric_Pad1.05x0.95mm_HandSolder; Manufacturer PN C0603C103J5RACTU
C11, C14, C26: 0.1uF; C_0603_1608Metric_Pad1.05x0.95mm_HandSolder; Manufacturer PN CGA3E2X7R1H104K080AA
C15: 10uF; CP_EIA-3528-12_Kemet-T_Pad1.50x2.35mm_HandSolder; Manufacturer PN T491B106K016ATAUTO
C17, C18: 10pF; C_0603_1608Metric_Pad1.05x0.95mm_HandSolder; Manufacturer PN C0603C100J5GAC3190
D3: GREEN_LED; R_0603_1608Metric_Pad1.05x0.95mm_HandSolder; Manufacturer PN 150060VS75000
D4: RED_LED; R_0603_1608Metric_Pad1.05x0.95mm_HandSolder; Manufacturer PN 150060RS75000
D8, D9: SMBJ9.0CA-13-F; D_SMB_Handsoldering; Manufacturer PN SMBJ9.0CA-13-F
J3: Programming Header; PinHeader_1x06_P2.54mm_Vertical
J4: Board Interconnect; PinHeader_1x02_P2.54mm_Vertical
R4, R15, R16, R18: 10k; R_0603_1608Metric_Pad1.05x0.95mm_HandSolder; Manufacturer PN ERJ-PA3J103V
R5: 470; R_0603_1608Metric_Pad1.05x0.95mm_HandSolder; Manufacturer PN ERJ-PA3J471V
R6, R9: 0; R_2816_7142Metric_Pad3.20x4.45mm_HandSolder; Manufacturer PN 5102
R7: 120; R_0603_1608Metric_Pad1.05x0.95mm_HandSolder; Manufacturer PN ERJ-PA3J121V
R8: 4m; R_4020_10251Metric_Pad1.65x5.30mm_HandSolder; Manufacturer PN WSLP39214L000FEB
R10, R11: 1.2k; R_0603_1608Metric_Pad1.05x0.95mm_HandSolder; Manufacturer PN ERJ-PA3J122V
R12, R13: 75k; R_0603_1608Metric_Pad1.05x0.95mm_HandSolder; Manufacturer PN ERJ-PA3J753V
R14, R22: 1k; R_0603_1608Metric_Pad1.05x0.95mm_HandSolder; Manufacturer PN ERJ-PA3J102V
R17, R19: 4.99k; R_0603_1608Metric_Pad1.05x0.95mm_HandSolder; Manufacturer PN RCS06034K99FKEA
R20, R21: 300; R_0603_1608Metric_Pad1.05x0.95mm_HandSolder; Manufacturer PN ERJ-PA3J301V
U2: NCV2007x; SOIC-14_3.9x8.7mm_P1.27mm; Manufacturer PN NCV20074DR2G
U3: dsPIC33EV32GM102; SSOP-28_5.3x10.2mm_P0.65mm; Manufacturer PN dsPIC33EV32GM102-E/SS
U4: MCP2542FDxMF; SOIC-8_3.9x4.9mm_P1.27mm; Manufacturer PN MCP2542FD-H/SN
Y1: 25 MHz; Crystal_SMD_S2.05mm_L2.55; Manufacturer PN ABM10AIG-25.000MHZ-4Z-T3

Connections:
+5V: C10.1, C11.1, C13.1, C14.1, J3.2, R4.1, R15.1, U3.13 (VDD), U3.28 (AVDD), U4.3 (VDD), U4.5 (VIO); also elsewhere on the board
+12V: R6.1; also elsewhere on the board
/CAN+: D8.1 (A1), R7.1, U4.7 (CANH); also elsewhere on the board
/CAN-: D9.1 (A1), R7.2, U4.6 (CANL); also elsewhere on the board
/MCU and CAN/CAN_RX: U3.23 (RPI44/PWM2H/RB12), U4.4 (RXD)
/MCU and CAN/CAN_STBY: U3.24 (RPI45/PWM2L/CTPLS/RB13), U4.8 (STBY)
/MCU and CAN/CAN_TX: U3.22 (RP43/PWM3L/RB11), U4.1 (TXD)
/MCU and CAN/ISENSE: C9.1, R14.1, U3.4 (PGED3/OA2IN-/AN2/C2IN1-/SS1/RPI32/CTED2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)
/MCU and CAN/LED1: R20.2, U3.25 (RPI46/PWM1H/T3CK/RB14)
/MCU and CAN/LED2: R21.2, U3.26 (RPI47/PWM1L/T5CK/RB15)
/MCU and CAN/MCLR: J3.1, R4.2, R5.1
/MCU and CAN/OSC1: C17.1, U3.9 (OSC1/CLKI/AN32/RPI18/RA2), Y1.3
/MCU and CAN/OSC2: C18.1, U3.10 (OSC2/CLKO/RPI19/RA3), Y1.1
/MCU and CAN/PGEC: J3.5, U3.6 (PGEC1/OA1IN+/AN4/C1IN3-/C1IN1+/C2IN3-/R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)
/MCU and CAN/PGED: J3.4, U3.7 (PGED1/OA1IN-/AN5/C1IN1-/CTMUC/RP35/RB3)
/MCU and CAN/SENSE+: J4.1, R6.2, R8.1, U2.5 (+)
/MCU and CAN/SENSE-: J4.2, R8.2, R9.1, U2.3 (+)
/MCU and CAN/VSENSE: C16.1, R22.1, U3.5 (PGEC3/OA1OUT/AN3/C1IN4-/C4IN2-/RPI33/CT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)
/MEAS_OUT: R9.2; also elsewhere on the board
/PWM: U3.21 (RP42/PWM3H/RB10); also elsewhere on the board
GND: C10.2, C11.2, C13.2, C14.2, C15.2, C17.2, C18.2, D3.1 (K), D4.1 (K), D8.2 (A2), D9.2 (A2), J3.3, J3.6, R16.2, U3.2 (OA2OUT/AN0/C2IN4-/C4IN3-/RPI16/RA0), U3.8 (VSS), U3.11 (FLT32/RP36/RB4), U3.12 (OA5IN+/AN24/C5IN3-/C5IN1+/RP20/T1CK/RA4), U3.14 (PGED2/SDA1/RP37/RB5), U3.15 (PGEC2/SCL1/RP38/RB6), U3.16 (OA5OUT/AN25/C5IN4-/C4IN1+/SCK1/RP39/INT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), U3.17 (AN26/CVREF1O/ASCL1/SDO1/RP40/T4CK/RB8), U3.18 (OA5IN-/AN27/C5IN1-/ASDA1/SDI1/RP41/RB9), U3.19 (VSS), U4.2 (VSS), U4.9 (VSS), Y1.4; also elsewhere on the board
GNDA: C9.2, C16.2, C24.2, C26.2, R12.2, R19.1, U2.11 (VSS), U3.27 (AVSS); also elsewhere on the board
unnamed: C15.1, U3.20 (VCAP)
unnamed: D3.2 (A), R20.1
unnamed: D4.2 (A), R21.1
unnamed: R5.2, U3.1 (MCLR)
unnamed: R10.1, R12.1, U2.10 (+)
unnamed: R10.2, U2.6 (-), U2.7
unnamed: R11.1, R13.2, U2.9 (-)
unnamed: R11.2, R17.2, U2.1, U2.2 (-)
unnamed: R13.1, R14.2, U2.8
unnamed: R15.2, R16.1, U3.3 (OA2IN+/AN1/C2IN1+/RPI17/RA1)
unnamed: R17.1, R18.2
unnamed: R18.1, R19.2, U2.12 (+)
unnamed: R22.2, U2.13 (-), U2.14
VS: C24.1, C26.1, U2.4 (VDD); also elsewhere on the board

Notes on the sheet:
Close to VDD TX pin
Close to VDD MCU pin
Green
Red
These 0 ohm resistors should be unsoldered when used with the secondary high-current sensing board
both pins 2 and 4 are connected to the lid, so only need to connect one to ground. After PCB layout, easier to connect only pin 4.
C17 = C18 = 2(CL - CS) Assuming 5pF stray capacitance CL = 10pF
Capacitor disconnected when programming
tantalum, < 1 Ohm ESR
Only one soldered
Configuration resistors
Use internal pull down for pin 1

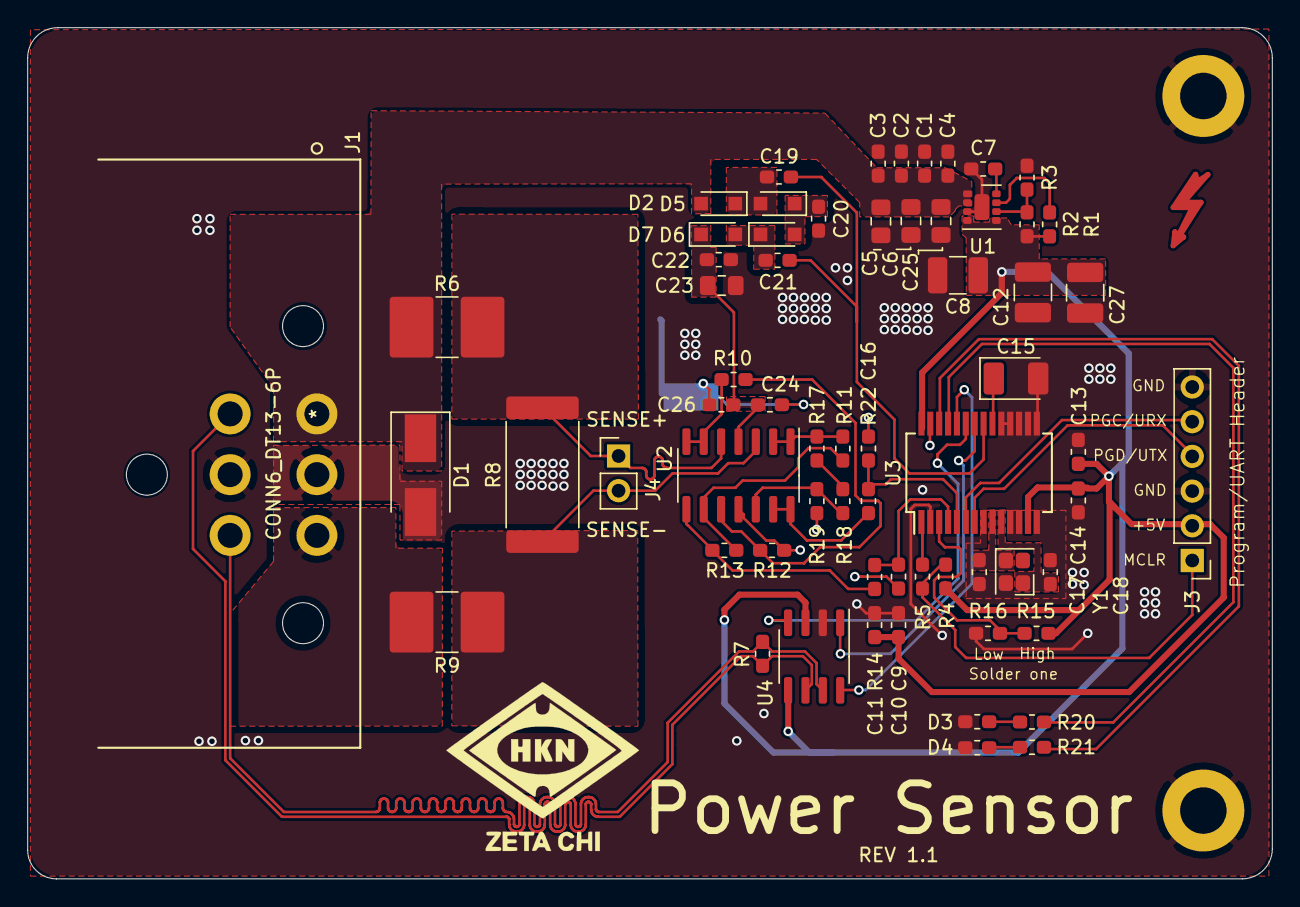
[picture p24: board PowerSenseModule.kicad_pcb from above]

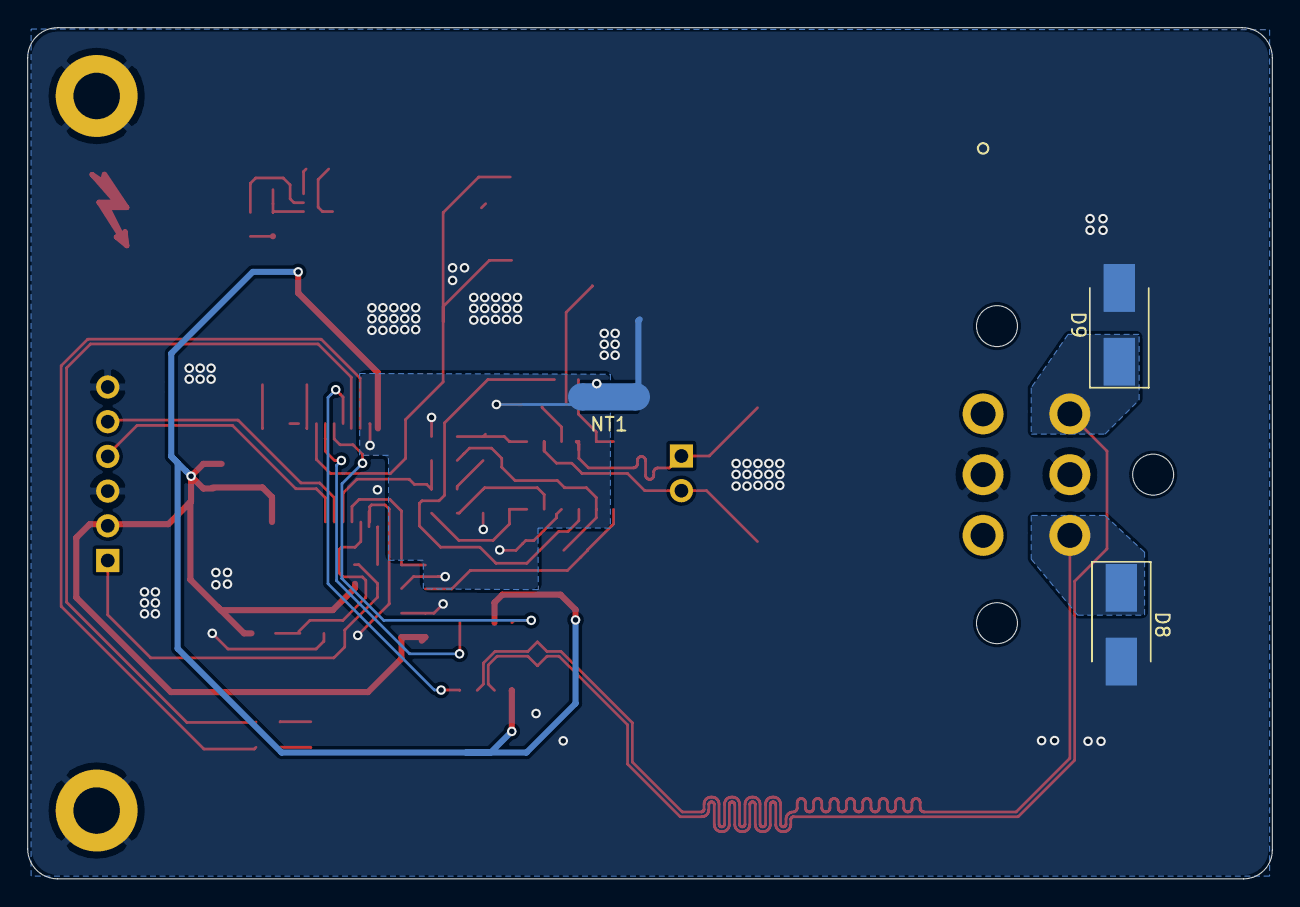
[picture p25: board PowerSenseModule.kicad_pcb from below]

Board: 2 copper layers, 91.1 x 62.3 mm, 71 parts (3 on the bottom side), 42 nets.

Other parts of the board:
Danger: Symbol_Highvoltage_Type1_CopperTop_Small
