plmwd/HKN-SAE-Project/PowerSenseModule.X/mcc_generated_files/pin_manager.h

/**
  PIN MANAGER Generated Driver File

  @Company:
    Microchip Technology Inc.

  @File Name:
    pin_manager.h

  @Summary:
    This is the generated manager file for the PIC24 / dsPIC33 / PIC32MM MCUs device.  This manager
    configures the pins direction, initial state, analog setting.
    The peripheral pin select, PPS, configuration is also handled by this manager.

  @Description:
    This source file provides implementations for PIN MANAGER.
    Generation Information :
        Product Revision  :  PIC24 / dsPIC33 / PIC32MM MCUs - 1.95-b-SNAPSHOT
        Device            :  dsPIC33EV32GM102
    The generated drivers are tested against the following:
        Compiler          :  XC16 v1.36
        MPLAB 	          :  MPLAB X v5.10
*/

/*
    (c) 2016 Microchip Technology Inc. and its subsidiaries. You may use this
    software and any derivatives exclusively with Microchip products.

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
    IN NO EVENT WILL MICROCHIP BE LIABLE FOR ANY INDIRECT, SPECIAL, PUNITIVE,
    INCIDENTAL OR CONSEQUENTIAL LOSS, DAMAGE, COST OR EXPENSE OF ANY KIND
    WHATSOEVER RELATED TO THE SOFTWARE, HOWEVER CAUSED, EVEN IF MICROCHIP HAS
    BEEN ADVISED OF THE POSSIBILITY OR THE DAMAGES ARE FORESEEABLE. TO THE
    FULLEST EXTENT ALLOWED BY LAW, MICROCHIP'S TOTAL LIABILITY ON ALL CLAIMS IN
    ANY WAY RELATED TO THIS SOFTWARE WILL NOT EXCEED THE AMOUNT OF FEES, IF ANY,
    THAT YOU HAVE PAID DIRECTLY TO MICROCHIP FOR THIS SOFTWARE.

    MICROCHIP PROVIDES THIS SOFTWARE CONDITIONALLY UPON YOUR ACCEPTANCE OF THESE
    TERMS.
*/

#ifndef _PIN_MANAGER_H
#define _PIN_MANAGER_H
/**
    Section: Includes
*/
#include <xc.h>

/**
    Section: Device Pin Macros
*/
/**
  @Summary
    Sets the GPIO pin, RA0, high using LATA0.

  @Description
    Sets the GPIO pin, RA0, high using LATA0.

  @Preconditions
    The RA0 must be set to an output.

  @Returns
    None.

  @Param
    None.

  @Example
    <code>
    // Set RA0 high (1)
    DCME_SetHigh();
    </code>

*/
#define DCME_SetHigh()          _LATA0 = 1
/**
  @Summary
    Sets the GPIO pin, RA0, low using LATA0.

  @Description
    Sets the GPIO pin, RA0, low using LATA0.

  @Preconditions
    The RA0 must be set to an output.

  @Returns
    None.

  @Param
    None.

  @Example
    <code>
    // Set RA0 low (0)
    DCME_SetLow();
    </code>

*/
#define DCME_SetLow()           _LATA0 = 0
/**
  @Summary
    Toggles the GPIO pin, RA0, using LATA0.

  @Description
    Toggles the GPIO pin, RA0, using LATA0.

  @Preconditions
    The RA0 must be set to an output.

  @Returns
    None.

  @Param
    None.

  @Example
    <code>
    // Toggle RA0
    DCME_Toggle();
    </code>

*/
#define DCME_Toggle()           _LATA0 ^= 1
/**
  @Summary
    Reads the value of the GPIO pin, RA0.

  @Description
    Reads the value of the GPIO pin, RA0.

  @Preconditions
    None.

  @Returns
    None.

  @Param
    None.

  @Example
    <code>
    uint16_t portValue;

    // Read RA0
    postValue = DCME_GetValue();
    </code>

*/
#define DCME_GetValue()         _RA0
/**
  @Summary
    Configures the GPIO pin, RA0, as an input.

  @Description
    Configures the GPIO pin, RA0, as an input.

  @Preconditions
    None.

  @Returns
    None.

  @Param
    None.

  @Example
    <code>
    // Sets the RA0 as an input
    DCME_SetDigitalInput();
    </code>

*/
#define DCME_SetDigitalInput()  _TRISA0 = 1
/**
  @Summary
    Configures the GPIO pin, RA0, as an output.

  @Description
    Configures the GPIO pin, RA0, as an output.

  @Preconditions
    None.

  @Returns
    None.

  @Param
    None.

  @Example
    <code>
    // Sets the RA0 as an output
    DCME_SetDigitalOutput();
    </code>

*/
#define DCME_SetDigitalOutput() _TRISA0 = 0
/**
  @Summary
    Sets the GPIO pin, RA1, high using LATA1.

  @Description
    Sets the GPIO pin, RA1, high using LATA1.

  @Preconditions
    The RA1 must be set to an output.

  @Returns
    None.

  @Param
    None.

  @Example
    <code>
    // Set RA1 high (1)
    HIGH_IE_SetHigh();
    </code>

*/
#define HIGH_IE_SetHigh()          _LATA1 = 1
/**
  @Summary
    Sets the GPIO pin, RA1, low using LATA1.

  @Description
    Sets the GPIO pin, RA1, low using LATA1.

  @Preconditions
    The RA1 must be set to an output.

  @Returns
    None.

  @Param
    None.

  @Example
    <code>
    // Set RA1 low (0)
    HIGH_IE_SetLow();
    </code>

*/
#define HIGH_IE_SetLow()           _LATA1 = 0
/**
  @Summary
    Toggles the GPIO pin, RA1, using LATA1.

  @Description
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
    Sets the GPIO pin, RB15, low using LATB15.

  @Description
    Sets the GPIO pin, RB15, low using LATB15.

  @Preconditions
    The RB15 must be set to an output.

  @Returns
    None.

  @Param
    None.

  @Example
    <code>
    // Set RB15 low (0)
    LED_G_SetLow();
    </code>

*/
#define LED_G_SetLow()           _LATB15 = 0
/**
  @Summary
    Toggles the GPIO pin, RB15, using LATB15.

  @Description
    Toggles the GPIO pin, RB15, using LATB15.

  @Preconditions
    The RB15 must be set to an output.

  @Returns
    None.

  @Param
    None.

  @Example
    <code>
    // Toggle RB15
    LED_G_Toggle();
    </code>

*/
#define LED_G_Toggle()           _LATB15 ^= 1
/**
  @Summary
    Reads the value of the GPIO pin, RB15.

  @Description
    Reads the value of the GPIO pin, RB15.

  @Preconditions
    None.

  @Returns
    None.

  @Param
    None.

  @Example
    <code>
    uint16_t portValue;

    // Read RB15
    postValue = LED_G_GetValue();
    </code>

*/
#define LED_G_GetValue()         _RB15
/**
  @Summary
    Configures the GPIO pin, RB15, as an input.

  @Description
    Configures the GPIO pin, RB15, as an input.

  @Preconditions
    None.

  @Returns
    None.

  @Param
    None.

  @Example
    <code>
    // Sets the RB15 as an input
    LED_G_SetDigitalInput();
    </code>

*/
#define LED_G_SetDigitalInput()  _TRISB15 = 1
/**
  @Summary
    Configures the GPIO pin, RB15, as an output.

  @Description
    Configures the GPIO pin, RB15, as an output.

  @Preconditions
    None.

  @Returns
    None.

  @Param
    None.

  @Example
    <code>
    // Sets the RB15 as an output
    LED_G_SetDigitalOutput();
    </code>

*/
#define LED_G_SetDigitalOutput() _TRISB15 = 0

#define IIN_ANALOG_INPUT      2       // RB0, AN2
#define VIN_ANALOG_INPUT      3       // RB1, AN3

#define test_SetDigitalOutput()  _TRISB2 = 0
#define test_SetDigitalPin()     _ANSB2 = 0
#define test_SetHigh()           _LATB2 = 1
#define test_SetLow()            _LATB2 = 0

/**
    Section: Function Prototypes
*/
/**
  @Summary
    Configures the pin settings of the dsPIC33EV32GM102
    The peripheral pin select, PPS, configuration is also handled by this manager.

  @Description
    This is the generated manager file for the PIC24 / dsPIC33 / PIC32MM MCUs device.  This manager
    configures the pins direction, initial state, analog setting.
    The peripheral pin select, PPS, configuration is also handled by this manager.

  @Preconditions
    None.

  @Returns
    None.

  @Param
    None.

  @Example
    <code>
    void SYSTEM_Initialize(void)
    {
        // Other initializers are called from this function
        PIN_MANAGER_Initialize();
    }
    </code>

*/
void PIN_MANAGER_Initialize (void);

#endif
