plmwd/HKN-SAE-Project/PowerSenseModule.X/sampling_manager.h

/* 
 * File:   sampling.h
 * Author: Paul
 *
 * Created on December 29, 2019, 7:08 PM
 */

#ifndef SAMPLING_MANAGER_H
#define	SAMPLING_MANAGER_H

void SAMPLING_MANAGER_Initialize(void);

#endif	/* SAMPLING_MANAGER_H */
