plmwd/HKN-SAE-Project/(commit log)

2019-06-24 Created MCU circuit KiCAD project
    [MCU.kicad_pcb, MCU.sch]
2019-07-01 KiCAD Project
    Created KiCAD project and created symbols for the dsPIC33EP32GP502 (schematic) for the QFN and SSOP and SOIC package.
    [MCU.sch]
2019-07-03 Added CAN Trans IC and Programmer Header
    [MCU.sch]
2019-07-03 Organized and set footprints
    Organized schematic page (title, company) and added footprints for all parts besides the passives
    [MCU.sch]
2019-07-03 Previous push
    [MCU.sch]
2019-07-04 no change
    [MCU.sch]
2019-07-04 Addc global nets to CPU
    Added global nets to CPU for the power sensor IC
    - events 1 and 2
    - adc reset and mclr (need to add pull-up resistors)
    - zero crossing
    [MCU.sch]
2019-07-04 Created KiCAD Project for sensing portion
    [Sensing.kicad_pcb, Sensing.sch]
2019-07-05 Buck Converter design - all that's needed is resistor placement which can be derived from powerbench and wiring for the regulator and output.
    [Buck_Converter.kicad_pcb, Buck_Converter.sch]
2019-07-07 Fixed library reference error
    MCU library was using a cached version
    [MCU.sch]
2019-07-07 Created power sensor circuit
    ADC filter:
    RC chosen so that fc ~= 8KHz (998k and 12p)
    ADC voltage divider:
    30V -> 1V
    10V -> 0.333
    24 bit adc provides 59.6nV/bit - adequate room
    [Sensing.sch]
2019-07-07 Changed adc filters
    Changed adc filters to have a cutoff close to 50KHz so that the attenuation at 500-1000Hz is 0.98 to 0.99.
    Voltage adc:
    Reff = 33.63K - > C = 820pF
    Current adc:
    R = 1K -> C = 3nF
    [Sensing.sch]
2019-07-07 Created MPLAB project
    Created MPLAB project for the dsPIC33EP32GP502 MCU. Used MCC to generate code for IO, CAN, UART, flash, and CRC. However, everything besides the IO (which has been up using pin mapping spreadsheet), needs to be configured. System config needs to setup as well (oscillator, watchdog, etc).
    [can1.c, can1.h, can_types.h, main.c]
2019-07-07 Merged branches and organized
    Merged Sensing, MCU, and Power branches to now use GITFlow. Merged schematics to new KiCAD project where now the schematics are hierarchical.
    Fixed MCLR and RST pins for MCP39F511A.
    [MCU.sch, PowerSenseModule.kicad_pcb, PowerSenseModule.sch, sensing.sch]
2019-07-07 archived old schematics into zip
2019-07-11 Modified C file. Added function prototypes
    Function prototypes are created in main for pingVoltage and for pingCurrent.
2019-07-11 Using project library
    Changed library ref to project not global
    [MCU.sch, PowerSenseModule.sch, sensing.sch]
2019-07-11 Changed power connector and added CAN nets
    [MCU.sch, PowerSenseModule.sch, sensing.sch]
2019-07-18 Added libraries folder and updated .gitignore
    [Buck_Converter.kicad_pcb, Buck_Converter.sch, MCU.kicad_pcb, MCU.sch, Sensing.kicad_pcb, Sensing.sch]
2019-07-20 Added linear reg, cleaned up schematic
    [MCU.sch, PowerSenseModule.sch, sensing.sch]
2019-07-20 Lin Reg Connected with cap, global power net, and wiring.
    [MCU.sch, PowerSenseModule.sch, sensing.sch]
2019-07-20 Updated footprints for resistors and caps`
    Chose 0603 hand solder footprints for R and C.
    Need choose footprint for the inductor, connectors, test points, programmer header, and jumper
    [PowerSenseModule.csv]
2019-07-20 Finalizing footprints - a
    Changed footprints of 4.7u, 10u, 47u ceramic caps to 0805 from 0603.
    Changed output cap of linear reg to 150u electrolytic
    Added tie net for grounds
    Connector footprints
    Added notes
    TODO:
    footprints of net tie, 150u electrolytic
    [MCU.sch, PowerSenseModule.sch, sensing.sch]
2019-07-20 Finalizing Footprints PT B
    Have two copies of everything, don't know why. Added NETI to remaining resistors and capacitor. Let's see
    [MCU.sch, PowerSenseModule.sch, sensing.sch]
2019-07-20 Changed C10 from tantalum to ceramic
    [MCU.sch]
2019-07-20 Fixed footprint library paths
    Changed TVS1400 clamp to project specific library and fixed library path for the microsip footprint
    [PowerSenseModule.sch]
2019-07-21 Changed R8 to be a 4 pin shunt resistor
    [sensing.sch]
2019-07-21 Changed can interface lib
    [MCU.sch]
2019-07-27 PCB Design Began. Design Changes are incoming though.
    PCB placement began, changes to schematic will be made. Reference google docs for said changes along with date.
    [MCU.sch, PowerSenseModule.kicad_pcb, PowerSenseModule.sch, sensing.sch]
2019-07-28 Selected parts in BOM
    [PowerSenseModule.csv, PowerSenseModule.xlsx]
2019-07-28 Started design change
    Changing MCU to 5V dspic33ev32gm102
    [MCU.sch, PowerSenseModule.sch, sensing.sch]
2019-08-04 Redesign
    Removed MCP power sensor for 4 op amps - buffers, differential amplifier, and active low pass, feeds into MCU adc.
    [MCU.sch, PowerSenseModule.csv, PowerSenseModule.sch, PowerSenseModule.xlsx]
2019-08-04 Added/Changed footprints
    [MCU.sch, PowerSenseModule.sch]
2019-08-04 Cleaned up MCU page
    [MCU.sch]
2019-08-06 Moses's changes, removed MPLAB proj
    [MCU.sch, PowerSenseModule.kicad_pcb, PowerSenseModule.sch]
2019-08-06 Merged power and CAN connectors to one connector
    [PowerSenseModule.sch]
2019-08-06 BASE/REFERENCE
    Initial Design.
    [MCU.sch, PowerSenseModule.kicad_pcb]
2019-08-06 Added CAN and ADC MCC modules
    Setup I/O for digital I/O and ADC. Need to configure CAN using peripheral multiplexing. Also need to properly configure the ADC and CAN.
2019-08-06 Rewiring - of MCU
    Rewired the MCU
    [MCU.sch]
2019-08-06 FINAL BASIS/REFERENCE
    Rewiring done to proper pins on MCU
    [MCU.sch, PowerSenseModule.kicad_pcb]
2019-08-07 Wrote basic framework
    Removed CAN MCC module (for now).
    Configured ADC for CH0 and CH1 simultaneous sampling, sequential conversion. Generates interrupt after 16 samples (8 samples per channel) - doesn't yet use DMA. Wrote basic main loop and ADC interrupt to process sampled data.
    calibration function
    CAN functions and configuration
    TESTING
    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
    [adc1.c, can1.c, can1.h, can_types.h]
2019-08-07 Fixed bugs, tested sampling
    Fixed configuration bugs: CH0S wrong pin, ASAM wasnt set.
    Tested sampling: ADC interrupt works and loads data into buffer, passes to main loop, and data gets processed.
    CAN configuration and data transmitting/error handling
    Adjusting data based off of calibration data
    Proper ADC sampling timing
    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
    [adc1.c, main.c]
2019-08-07 Added calibration.h and added some documentation
2019-08-08 PCB - Power tracing
    Front tracing for most part done.
    [PowerSenseModule.kicad_pcb]
2019-08-08 edited .gitignore, calibration.h documentation refactor
2019-08-09 Added to PCB layout - Configurations Resistor / PIN 3 mapping
    More of the PCB is laid out. Some mapping remains. Aside from that, what's left is the following,
    - Assuring PCB traces meet current limitations
    - Design review for optimizations for redesign.
    Alongside that, the configuration resistors do not seem to be connected to PIN 3 on the MCU.
    [PowerSenseModule.kicad_pcb]
2019-08-10 Added some device parameters & renamed project to "PowerSenseModule"
2019-08-11 Started using tmr1 to trigger tmr3 that triggers the adc
2019-08-12 Cleaned up timer 1 and 3 code
2019-08-12 Redesign/Configuration Resistors Fixed
    Dimensions for PCB defined, might need to be extended for mounting. Rewiring being done to fit dimensions.
    [MCU.sch, PowerSenseModule.kicad_pcb]
2019-08-13 Redesign - Everything up top
    This redesign has all components on top layer. Tracing is all that's left, along side labeling.
    [PowerSenseModule.kicad_pcb]
2019-08-16 DMA init code and gitignore
    Updated .gitignore
    Wrote DMA initialization code for any channel
    Need to configure and test DMA for CAN and ADC
2019-08-22 Changed data types of current and voltage variables/arrays in main to double
2019-08-22 Started CAN init - TX
    CAN init TODO:
    RX - don't know what we would be receiving & filter
    DMA
    Bit timing
    CAN TODO:
    message struct
    functions for sending messages, etc
    Changes TODO:
    system clock
2019-08-22 Design changes/comments
    Reorienting everything to keep power traces and signal traces seperate as possible
    [PowerSenseModule.kicad_pcb]
2019-08-22 OP amp circuit changes
    Move D op amp to voltage sensing
    Changed voltage divider resistors to smaller values
    Changed error in differential amp resistor values (gain)
    Changed error in resistors have capacitor footprints
    Added datasheet link for the op amps
    [MCU.sch]
2019-08-23 Added pdf of pcb
2019-08-24 CAN TX writing to buffer
    Added function to be able to write data of any data type to the data fields in a CAN TX buffer.
    I think the initialization is correct but needs testing.
    Added struct for a CAN message.
    Changed variable type of buffers in global.h.
    Need to write transmit function and test.
    [can.c, can.h, globals.h]
2019-08-24 Wrote and tested CAN functions
    Added function to configure a TX buffer for standard data frame
    Wrote transmission function
    Moved normal operation request to the end of initialization
    Reorganized can_msg_t to be only one struct - verified ordering
2019-08-25 Configured DMA for CAN TX and RX
2019-08-25 DMA small changes - need to refactor
2019-08-25 Fixed DMA errors and added globals.c
    Added definition of global variables in globals.c
    Fixed DMA undefined and multi-instances compile errors
    [dma.c, globals.h]
2019-08-25 Added more documentation and empty CAN interrupt ISRs
2019-08-25 Misc CAN/DMA
    Manually wrote address for CAN registers for DMA PAD register.
    Now clears interrupt flag in CAN ISR
    Problems:
    ISR not getting called with TX request
    [can.c, dma.c, globals.h, main.c]
2019-09-04 Got CAN to transmit
    CAN now transmits correct data, but on Waveforms, I get CRC errors. Also, Unless I clear the request bit, the message will be repeatedly sent unto eternity because of a invalid CAN message error - need to read BOSCH CAN specification.
    Refactored some DMA code, including adding channel enable/disable functions
    [can.c, can.h, dma.c, dma.h, globals.h, main.c]
2019-09-07 Finished prototype of CalibrateData. Changed return type to double as well as data type of data to double. Changed all member variables of cal_point_t structure to doubles from unsigned int
2019-09-11 Every component wired.
    Each component is wired. I've now decided to make this PCB symmetric though.
    [MCU.sch, PowerSenseModule.kicad_pcb]
2019-09-13 Misc CAN and implemented device config
    Added device config and functions for easy switching between clock speeds, CAN & UART baud rates, and ADC sampling rates by just defining a few options (#define [OPTION]).
    Refactored code here and there.
    Added more documentation for CAN
    Added more CAN error enums
    [adc1.c, calibration.h, can.c, can.h, device_configuration.h, dma.c]
2019-09-13 Finished device config - next test
2019-09-13 started UART config
2019-12-09 misc - PCB
    [PowerSenseModule.kicad_pcb]
2019-12-10 Updated symbol fields and changed CAN transceiver package to make it easier to solder
    [MCU.sch, PowerSenseModule.kicad_pcb, PowerSenseModule.sch]
2019-12-10 Added charge pump
    Added charge pump for OP amp positive supply rail and reorganized the MCU page.
    [MCU.sch, PowerSenseModule.sch]
2019-12-10 Changed global nets to local nets in MCU page
    [MCU.sch]
2019-12-10 Annotated new symbols
    [MCU.sch, PowerSenseModule.sch]
2019-12-11 Added diode footprints to charge pump and changed oscillator caps from 10u to 10p
    [MCU.sch, PowerSenseModule.sch]
2019-12-11 Added info in symbol fields for diodes
    [MCU.sch, PowerSenseModule.sch]
2019-12-11 Cleaned up main page of the schematic
    [MCU.sch, PowerSenseModule.sch]
2019-12-11 PCB update
    - Laid out buck converter
    - Laid out TE connector, TVS diode, and power sense resistor
    - Created footprint for 4-pin crystal
    - Updated crystal symbol
    - Fixed design rules
    - Moses's PCB design file name appended with *_backup
    [MCU.sch, PowerSenseModule.kicad_pcb, PowerSenseModule.sch, PowerSenseModule_backup.kicad_pcb]
2019-12-12 Adjusted copper fill zones
    [PowerSenseModule.kicad_pcb]
2019-12-12 Laid out crystal and grouped together components
    [MCU.sch, PowerSenseModule.kicad_pcb]
2019-12-12 Changed crystal gnd net and working on layout
    [MCU.sch, PowerSenseModule.kicad_pcb, PowerSenseModule.sch]
2019-12-12 layout 0.01
    [MCU.sch, PowerSenseModule.kicad_pcb]
2019-12-12 layout 0.02
    most power is routed
    [PowerSenseModule.kicad_pcb, PowerSenseModule.sch]
2019-12-12 layout 0.03
    [PowerSenseModule.kicad_pcb]
2019-12-12 TODO notes
    - rotate buck to fill gap
    - pretty up voltage converters
    - adjust power copper fills to make room for ground fill between buck and charge pump
    [PowerSenseModule.kicad_pcb]
2019-12-13 layout 0.04
    - Added top and bottom ground plane
    - changed GNDD to GND
    - readjusted spacing between components
    - made the board a little smaller
    - fine tuned copper fills
    - got pretty good power rail and ground layout
    - length matched traces from sense resistor to op amp
    - repositioned LEDs
    - added text for LEDs
    - maybe reorganize passives between MCU and op amps
    - layout/route the three resistors for the op amps currently on the bottom of the PCB
    - move shunt resistor for CAN closer to connector (?)
    - route length tuned traces for CANH and CANL
    - GNDA copper fills
    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
    [MCU.sch, PowerSenseModule.kicad_pcb, PowerSenseModule.sch]
2019-12-14 layout 0.05
    - differential pair for CAN bus
    - differential pair for shunt resistor
    [MCU.sch, PowerSenseModule.kicad_pcb, PowerSenseModule.sch]
2019-12-14 layout 0.06
    - finished most of the routing
    TODO
    - deal with copper island
    - route GNDA
    [MCU.sch, PowerSenseModule.kicad_pcb]
2019-12-14 misc
    IDK what changes I did but there were some after saving before closing KiCAD
    [PowerSenseModule.kicad_pcb]
2019-12-14 layout 1.0
    [PowerSenseModule.kicad_pcb]
2019-12-15 layout 1.01
    - Changed 5V traces from 0.2mm to 0.45mm to handle at least 1A
    [PowerSenseModule.kicad_pcb]
2019-12-15 laylout 1.02
    adjusted 5V traces
    [PowerSenseModule.kicad_pcb]
2019-12-21 Generated gerber and fab files
    [MCU.sch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]
2019-12-21 Created BOM
    BOM was created by adding symbol fields then using the KiCAD BOM Wizard plugin
    https://hackaday.io/project/20765-kicad-bom-wizard
    Then the CSV data was imported into Excel and was tweaked.
    Price per unit is about $35-40
    [MCU.sch, PowerSenseModule.csv, PowerSenseModule.sch, PowerSenseModuleBOM.xlsx]
2019-12-22 Updated BOM, schematic, PCB
    - Using 3 pin jumper for program enable so that the jumper can be stored on the board
    - Updated footprint for 4.7uF cap from electrolytic to smd 0805
    - cleaned up some copper zones
    [MCU.sch, PowerSenseModule.csv, PowerSenseModule.kicad_pcb, PowerSenseModule.sch, PowerSenseModuleBOM.xlsx]
2019-12-24 Crystal and UART setup
    - removed everything but UART to get it working
    - Used MCC to setup UART, printf outputs to UART, and system CLK
    - Modified code to get crystal clock to work by setting NOSC before setting OSWEN and wait until the clock successfully switched over
2019-12-28 Prepped branch for reorganization
    - removed adc, tmr1, tmr3 files
    - renamed dma -> dma_backup
    - renamed main -> main_backup
    - commented out main
2019-12-28 Added files to project
    - added backup files from Firmware branch merge
    - remove uart (not uart1) files from Firmware branch
2019-12-28 Fixed conflicts with merge
    - Lots of things are broken, but testing individual peripherals before fixing main system software
    - Use #define in "device_configuration" file for debug main functions
    [clock_backup.c, clock_backup.h, device_configuration.h, main.c, test_uart1.c]
2019-12-28 Fixed some MCC stuff but not all
    - only system and UART setting in MCC and I cant seem to import the old settings fml
    [pin_manager.c]
2019-12-28 Somehow adc and tmr 1 and 3 files disappeared in merge - added back
2019-12-28 MPLAB added adc and tmr files
2019-12-28 Made uart change baud rate based off frequency
2019-12-31 Started rewritting ADC firmware to support manual and automatic sampling
2020-01-02 Started rework of the ADC firmware
    - Manual single channel sampling requests n number of consecutive samples
    [adc1.c]
2020-01-02 Started implementation for multichannel sampling
    - Need to rethink how to deal with reading ADC buffers
2020-01-02 Figured out how to process ADC buffer for multiple channels
    using cascaded switch statement to only modify channel buffers depending on the channel mode
2020-01-03 Bug fix- ADC ISR
    - tested single channel ADC functions - working perfectly
    - fixed bug in the ADC ISR, specifically the exit condition to do another sample had reversed logic
    [adc1.c, device_configuration.h, pin_manager.c, pin_manager.h, test_adc.c]
2020-01-03 Tested multichannel sampling functions
    - multichannel sampling works perfectly
    - Reversed argument order for ADC1_SampleChannels function
    - Added check in ADC1_setPrecision function to force the precision to be 10 bits if the channel mode is dual or multi channel - restriction of the dsPIC
    [adc1.c, test_adc.c]
2020-01-04 Documented and refactored code
    - refactored code to remove the channel_buffer_t struct and for the ADC1_SampleChannels() function, 4 arguments replaced the channel_buffer_t struct that are uint16_t pointers.
    - added documentation to the new ADC functions
    - Some features could be added, like continuous sampling (ADC samples indefinitely), sequential channel sampling, but there is all the functionality we need for our project at the moment.
    [adc1.c, test_adc.c]
2020-01-05 Tested PPS on PGD/C pins
    - Don't need to do anything special to have PPS work along side the programming data and clock pins. They can share the pins and if the programmer is connected, then it takes precedence. Since only one is possible to be plugged in, then all that needs to be done is to configure UART to be on the PG pins
2020-01-05 Remapped UART pins to PGD and PGC
2020-01-05 Started refactor of CAN and DMA code
    - untested
    - refactored CAN code to allow for a single function to send data rather than some convoluted series of functions
2020-01-06 Fixed some bugs - not transmitting
    - fixed bug checking for SID bounds where the number wasnt 2^11
    - fixed bug where the WriteTXBuffer() function was starting at the beginning of the CAN message, not where the beginning of the data section is in the message
    - The CAN message doesnt appear on the pin. Could be DMA config or something else with initiating the transfer
    [can1.c, can1.h, device_configuration.h, pin_manager.c, test_can.c]
2020-01-10 Removed Board folder from firmware
    causing merge issues (??)
    [MCU.sch, PowerSenseModule.kicad_pcb, PowerSenseModule.sch, sensing.sch]
2020-01-10 pop stash - weird merge issues with PCB
    [can.c, can.h, can1.c, can1.h, can_types.h, device_configuration.h, dma.c, dma.h]
2020-01-10 Recreated makefile, deleted Board files
    [PowerSenseModule.kicad_pcb]
2020-01-11 Wrote system test for op amp and ADC
    - added "power_sense_module" header and source file for ADC reading conversion from integer value to double current and voltages
    - wrote main function to test op amp and ADC
    - forgot to first implement the PWM module to get a higher op amp VDD
2020-01-11 Configured and tested PWM module on PCB rev 1.0
    - Configured PWM3H to output at a 50% duty cycle at 100KHz with all other PWM outputs disabled
    - PWM should be tested at various frequencies. Analysis showed that the PWM frequency should be at least 60KHz
2020-01-12 PCB rev 1.10
    >See GitHub issue for changes:
    https://github.com/paulwood15/HKN-SAE-Project/issues/16
    > Need to update BOM and do design review
    [MCU.sch, PowerSenseModule.kicad_pcb, PowerSenseModule.sch]
2020-01-13 PCB rev 1.11
    - replaced 47 uF electrolytic with 3 22 uF because it's cheaper and to account for derating
    - updated BOM
    - added inventory
    > need to merge two excel sheets (inventory and BOM)
    - added TVS zener diodes for CAN+ and CAN-
    - updated input protection diode with the one used by CAN+ and CAN-
    - rerouted CAN+ and CAN- for pinout change in main connector (DT13-6P)
    - changed pinout of the DT13-6P so that the protection diode copper fills would be symmetric
    - added 0.1 uF decoupling cap to op amp VDD input
    - added danger high voltage graphic copper and mask
    [Inventory.xlsx, MCU.sch, PowerSenseModule.csv, PowerSenseModule.kicad_pcb, PowerSenseModule.sch, PowerSenseModule.xlsx]
2020-01-15 Moved op amp decoupling cap closer to Vdd
    [PowerSenseModule.kicad_pcb]
2020-01-18 Updated inventory
    [Inventory.xlsx]
2020-01-18 Reorganized some code and tested ADC and V/I conversions
    - tested voltage and current sampling and conversion on breadboard with scaled (power wise) version of the circuit
    - found out I had V2 and V1 backward when doing the differential amplifier
    - moved resistances for diff amp and voltage divider to device_parameters.h
    - debugged test_system.c
    - > doing backslashes requires a carriage return
    - > The device was in non-blocking mode. changed to blocking
    - > ADC wasn't enabled
    - > print a few spaces at the end of every sampling print (before doing backslashes) to remove all text (when trying to remove a string longer than the next string)
    -
2020-01-19 schematic changes and PCB adjustments
    - had V2 and V1 reversed for differential amplifier so that was fixed by flipping U2C so that the non-inverting input was connected to (through a buffer) to SENSE+. The resistors and connections were adjusted to make the flip work.
    - changed hole size of the DT13-6P connector- they were correct in the first place (3mm not 5mm)
    [MCU.sch, PowerSenseModule.kicad_pcb]
2020-01-19 Added drawings dimensions, changed footprint of op amp, and cleaned up
    [Inventory.xlsx, MCU.sch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]
2020-01-19 Generated new gerber files just to be sure
    [PowerSenseModule-B_Adhes.gbr, PowerSenseModule-B_Cu.gbr, PowerSenseModule-B_Mask.gbr, PowerSenseModule-B_Paste.gbr, PowerSenseModule-B_SilkS.gbr, PowerSenseModule-Edge_Cuts.gbr, PowerSenseModule-F_Adhes.gbr, PowerSenseModule-F_Cu.gbr]
2020-01-19 Changed Dt13 footprint to be shorter and regen gerber
    [PowerSenseModule-B_Adhes.gbr, PowerSenseModule-B_Cu.gbr, PowerSenseModule-B_Mask.gbr, PowerSenseModule-B_Paste.gbr, PowerSenseModule-B_SilkS.gbr, PowerSenseModule-Edge_Cuts.gbr, PowerSenseModule-F_Adhes.gbr, PowerSenseModule-F_Cu.gbr]
2020-01-22 Made final changes to PCB
    - cleaned up vias
    - rounded edges
    - adjusted copper fills
    - ? dont remember what else - only minor, minor changes
    [PowerSenseModule-B_Adhes.gbr, PowerSenseModule-B_Cu.gbr, PowerSenseModule-B_Mask.gbr, PowerSenseModule-B_Paste.gbr, PowerSenseModule-B_SilkS.gbr, PowerSenseModule-Edge_Cuts.gbr, PowerSenseModule-F_Adhes.gbr, PowerSenseModule-F_Cu.gbr]
2020-01-24 Generated new BOM csv to make sure it's up to date before ordering
    [PowerSenseModule.csv, PowerSenseModule.xlsx]
2020-01-25 Updated BOM, got prices from suppliers
    [Inventory.xlsx, PowerSenseModule-Order-Digikey.csv, PowerSenseModule-Order.csv, PowerSenseModule.xlsx]
2020-02-13 Created interactive BOM for current design
2020-02-24 Minor changes to system test main function and current/voltage equations
    - Fixed wrong equation to calculate current and voltage
    - switched to PCB resistor values, not breadboard
    [device_configuration.h, device_parameters.h, power_sense_module.c, test_system.c]
